Viki-14/Projekt_BMS/BMS_PCB - V2/Bauteile/AMC1350DWVR/3D/AMC1350DWVR.stp

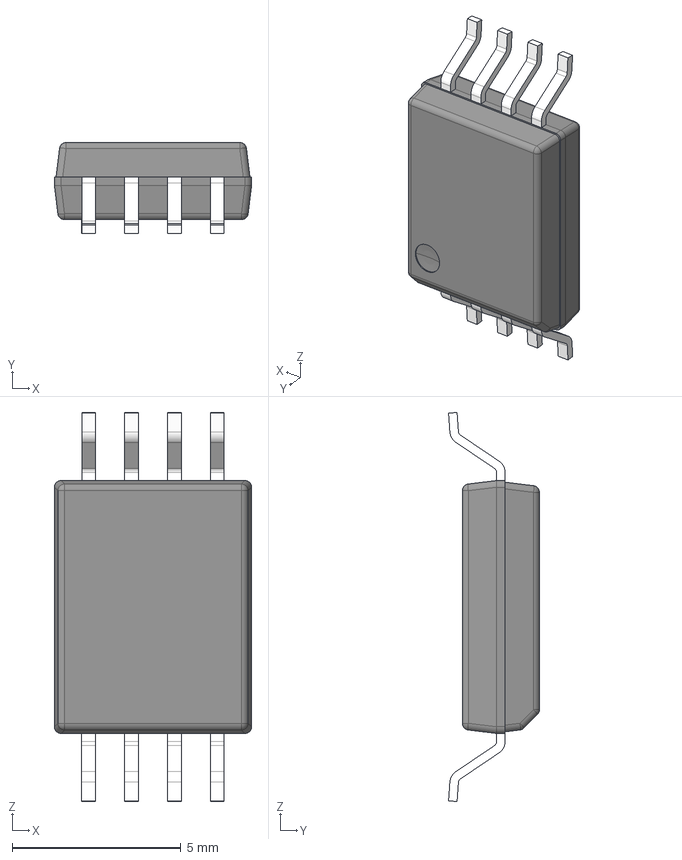
[picture p1: CAD file, 2025-04-29]
BMS_PCB - V2/Bauteile/AMC1350DWVR/3D/AMC1350DWVR.stp
5.85 x 2.70 x 11.5 mm
BODY-SOIC
LEAD-DWV0008A x 8
