Viki-14/Projekt_BMS/BMS_PCB - V2/Bauteile/LIB_REC15E-2412SZ/REC15E-2412SZ/3D/REC15E-2412SZ.stp

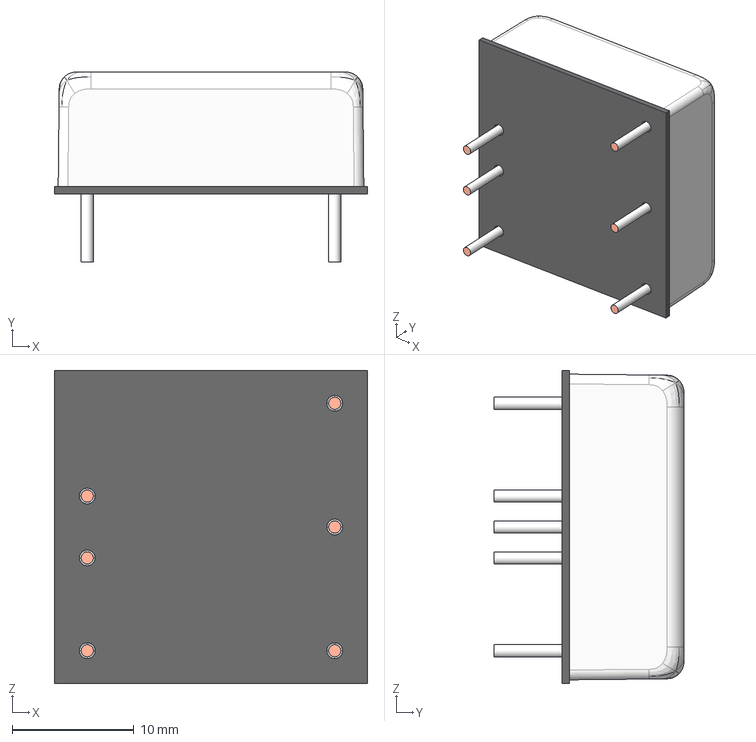
[picture p2: CAD file, 2025-04-29]
BMS_PCB - V2/Bauteile/LIB_REC15E-2412SZ/REC15E-2412SZ/3D/REC15E-2412SZ.stp
25.7 x 15.6 x 25.7 mm
