Viki-14/Projekt_BMS/BMS_PCB - V2/Bauteile/R1SE-0505-R/3D/R1SE-0505-R.stp

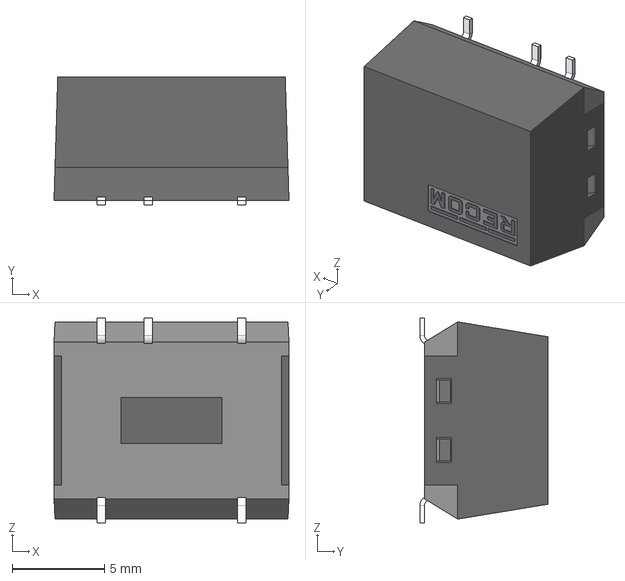
[picture p3: CAD file, 2025-04-29]
BMS_PCB - V2/Bauteile/R1SE-0505-R/3D/R1SE-0505-R.stp
12.8 x 6.95 x 11.1 mm
