Viki-14/Projekt_BMS/BMS_PCB - V2/Bauteile/TLV2401IDBVR/3D/TLV2401IDBVR.stp

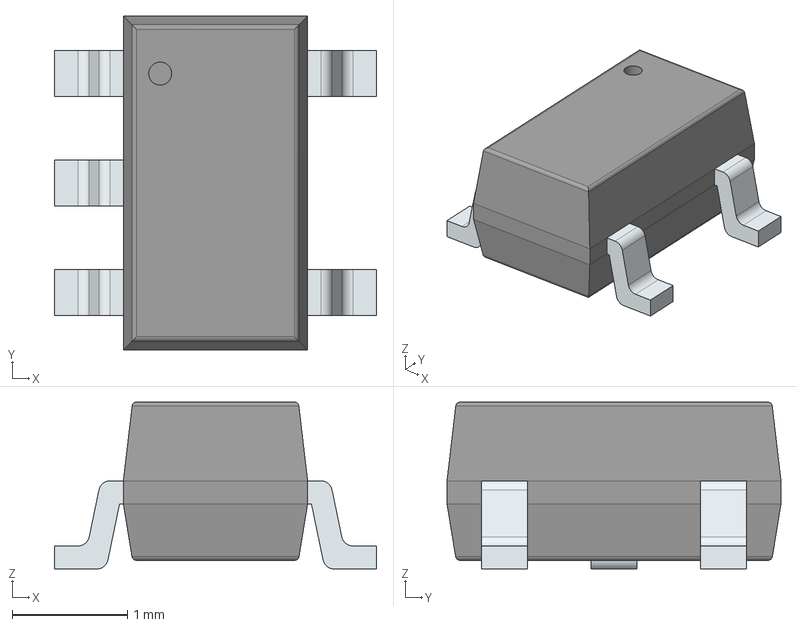
[picture p4: CAD file, 2025-04-29]
BMS_PCB - V2/Bauteile/TLV2401IDBVR/3D/TLV2401IDBVR.stp
2.80 x 2.90 x 1.45 mm
PinsArrayL
PinsArrayR
