Viki-14/Projekt_BMS/BMS_PCB - V2/Bauteile/TLV2402IDR/D0008A.stp

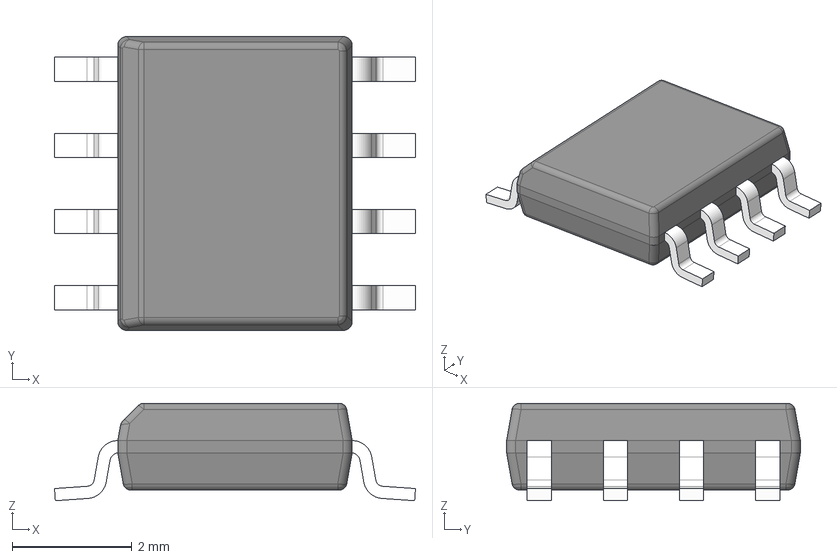
[picture p5: CAD file, 2025-04-29]
BMS_PCB - V2/Bauteile/TLV2402IDR/D0008A.stp
6.02 x 4.90 x 1.63 mm
BODY-SO
LEAD-D0008A x 8
