Viki-14/Projekt_BMS/BMS_PCB - V2/Bauteile/TLV2404IPW/PW0014A.stp

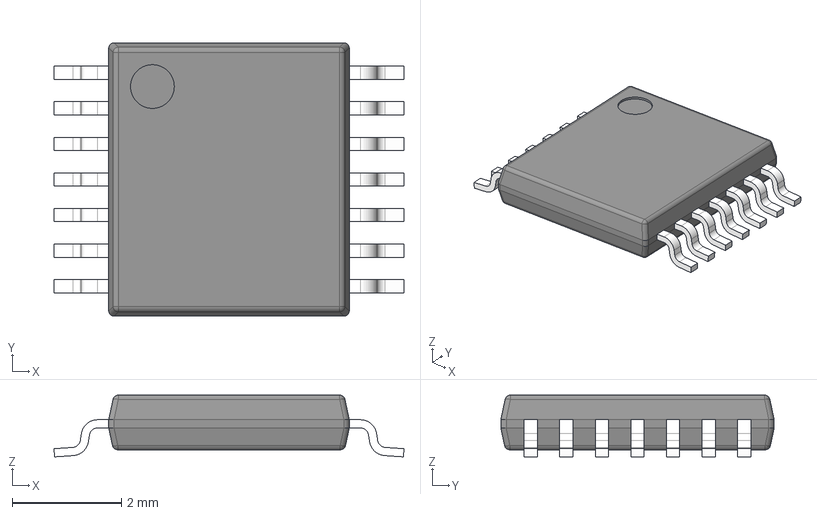
[picture p6: CAD file, 2025-04-29]
BMS_PCB - V2/Bauteile/TLV2404IPW/PW0014A.stp
6.40 x 5.00 x 1.13 mm
BODY-TSSOP
LEAD-TSSOP x 14
PIN1
