Viki-14/Projekt_BMS/BMS_PCB - V2/Bauteile/TPS70933DBVT/DBV0005A.stp

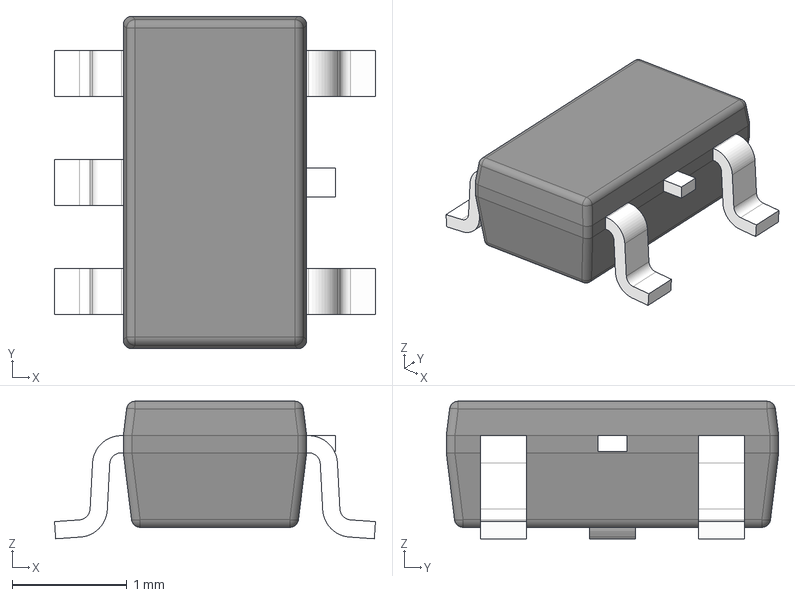
[picture p7: CAD file, 2025-04-29]
BMS_PCB - V2/Bauteile/TPS70933DBVT/DBV0005A.stp
2.80 x 2.90 x 1.20 mm
BODY-SOT
LEAD-SOT x 5
LEAD-DUMMY
