Viki-14/Projekt_BMS/BMS_PCB - V2/BMS_PCB.step

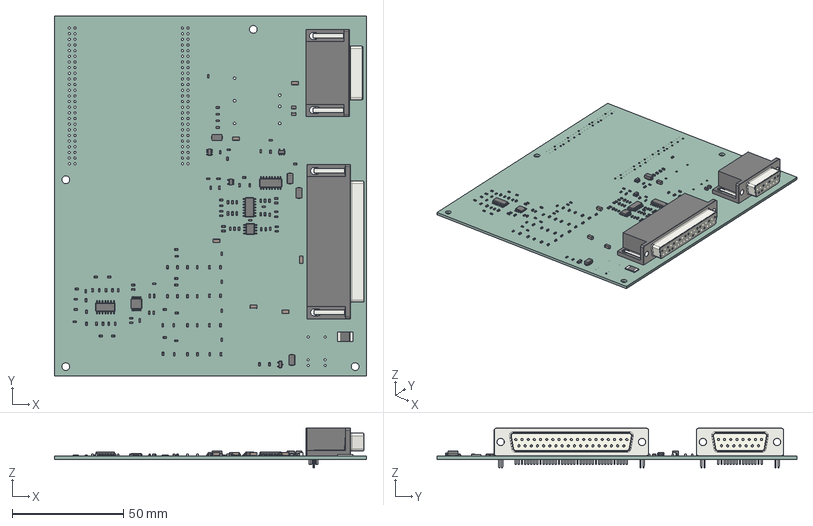
[picture p8: CAD file, 2025-05-05]
BMS_PCB - V2/BMS_PCB.step
140.2 x 161.7 x 17.9 mm
R_0603_1608Metric x 65
C_1206_3216Metric x 6
C_0603_1608Metric x 55
SOT-23-5 x 2
SOT-23-6
C_0805_2012Metric x 2
DSUB-37_Socket_Horizontal_P2.77x2.84mm_EdgePinOffset14.56mm_Housed_ MountingHolesOffset15.98mm
SOIC-16_3.9x9.9mm_P1.27mm
D_SMA x 4
DSUB-15_Socket_Horizontal_P2.77x2.84mm_EdgePinOffset14.56mm_Housed_ MountingHolesOffset15.98mm
SOIC-14_3.9x8.7mm_P1.27mm x 2
SOIC-8_3.9x4.9mm_P1.27mm
SOT-23-3
TSSOP-14_4.4x5mm_P0.65mm
R_2816_7142Metric
BMS_PCB_PCB
