Viki-14/Projekt_BMS/BMS_PCB - V2/Bauteile/TPS560430XFDBVT/3D/TPS560430XFDBVT.stp

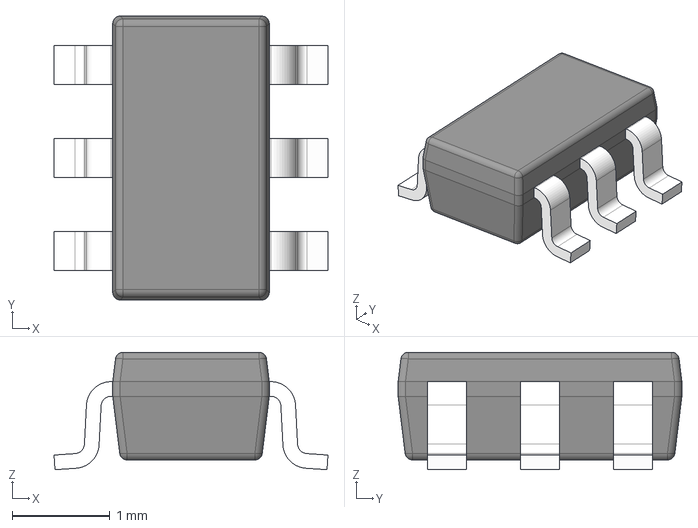
[picture p9: CAD file, 2025-04-29]
BMS_PCB - V2/Bauteile/TPS560430XFDBVT/3D/TPS560430XFDBVT.stp
2.80 x 2.90 x 1.20 mm
BODY-SOT
LEAD-SOT x 6
