Viki-14/Projekt_BMS/(list of files, cad)

Other CAD files:
BMS_PCB - V2/Bauteile/AMC1350DWVR/Allegro/soic127p1150x280-8n.psm
BMS_PCB - V2/Bauteile/AMC1350DWVR/DEHDL/amc1350dwvr/chips/chips.prt
BMS_PCB - V2/Bauteile/LIB_REC15E-2412SZ/REC15E-2412SZ/Allegro/rec15e2412sz.psm
BMS_PCB - V2/Bauteile/LIB_REC15E-2412SZ/REC15E-2412SZ/DEHDL/rec15e_2412sz/chips/chips.prt
BMS_PCB - V2/Bauteile/R1SE-0505-R/Allegro/r1se0505.psm
BMS_PCB - V2/Bauteile/R1SE-0505-R/DEHDL/r1se_0505_r/chips/chips.prt
BMS_PCB - V2/Bauteile/TLV2401IDBVR/Allegro/sot95p280x145-5n.psm
BMS_PCB - V2/Bauteile/TLV2401IDBVR/DEHDL/tlv2401idbvr/chips/chips.prt
BMS_PCB - V2/Bauteile/TPS560430XFDBVT/Allegro/sot95p280x145-6n.psm
BMS_PCB - V2/Bauteile/TPS560430XFDBVT/DEHDL/tps560430xfdbvt/chips/chips.prt
