Viki-14/Projekt_BMS/BMS_PCB - V2/BMS_PCB_schematic_v3.pdf

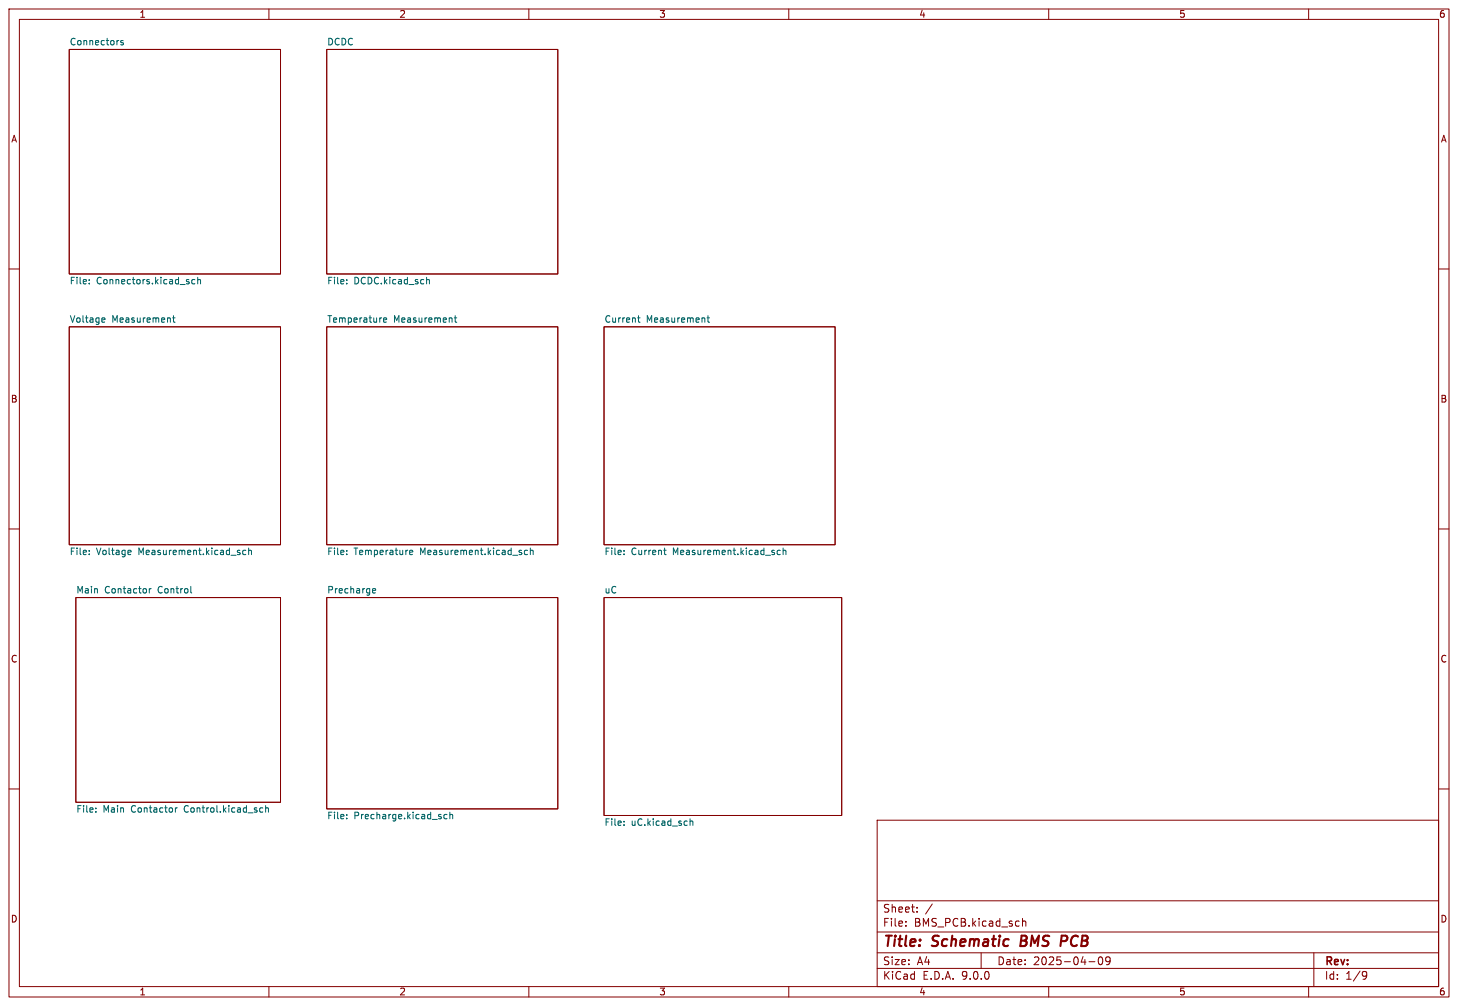
[picture p10: page 1]

Current Measurement File: Current Measurement.kicad_sch

File: uC.kicad_sch Precharge File: Precharge.kicad_sch

File: BMS_PCB.kicad_sch Sheet: /
Id: 1/9 Title: Schematic BMS PCB

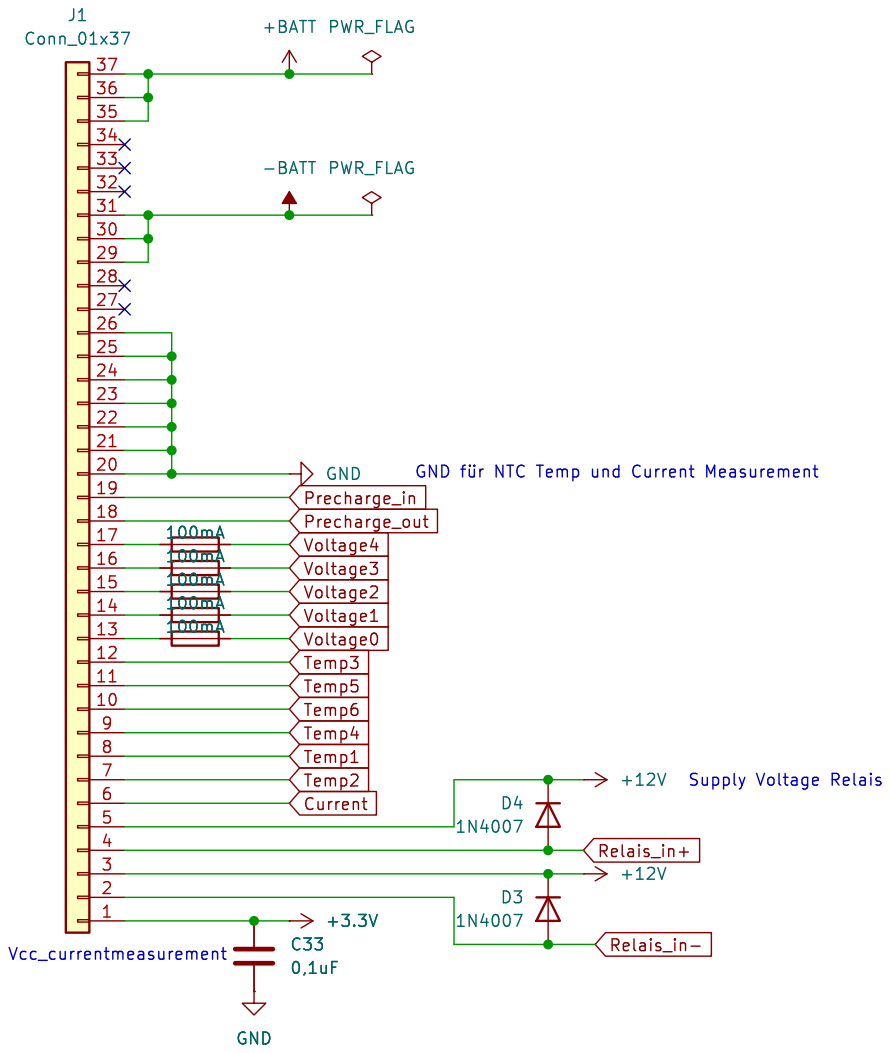
[picture p11: page 2]

Id: 2/9 Title: File: Connectors.kicad_sch Sheet: /Connectors/ D3

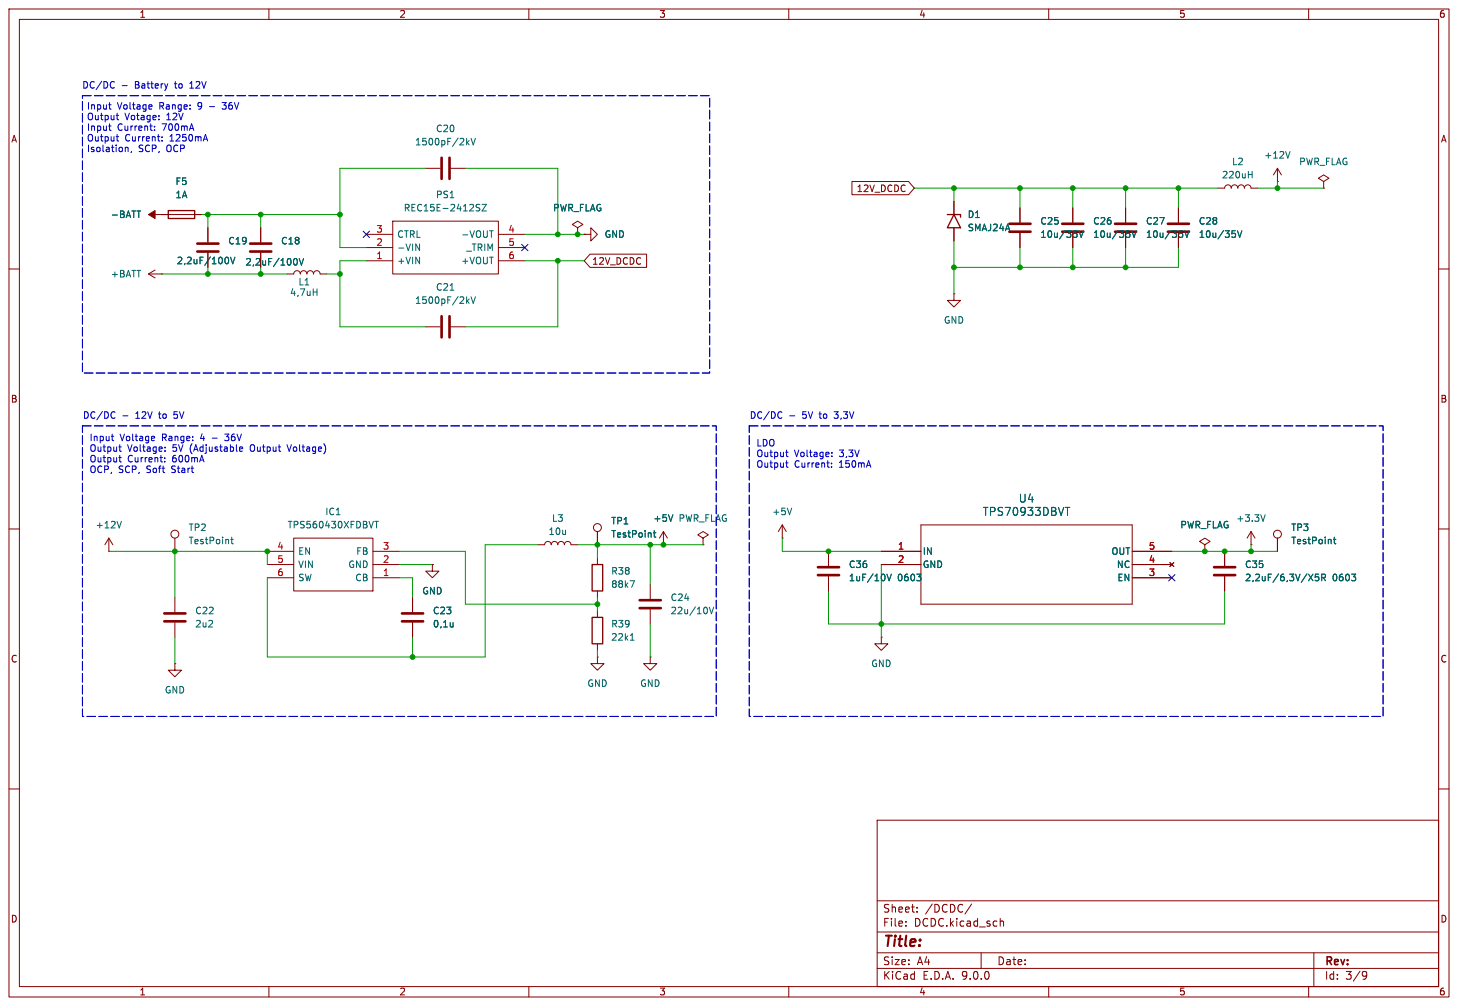
[picture p12: page 3]

Input Voltage Range: 9 - 36V Output Votage: 12V

Input Current: 700mA Output Current: 1250mA

LDO
Output Voltage: 3,3V Output Current: 150mA

Id: 3/9 Title: File: DCDC.kicad_sch Sheet: /DCDC/ C22

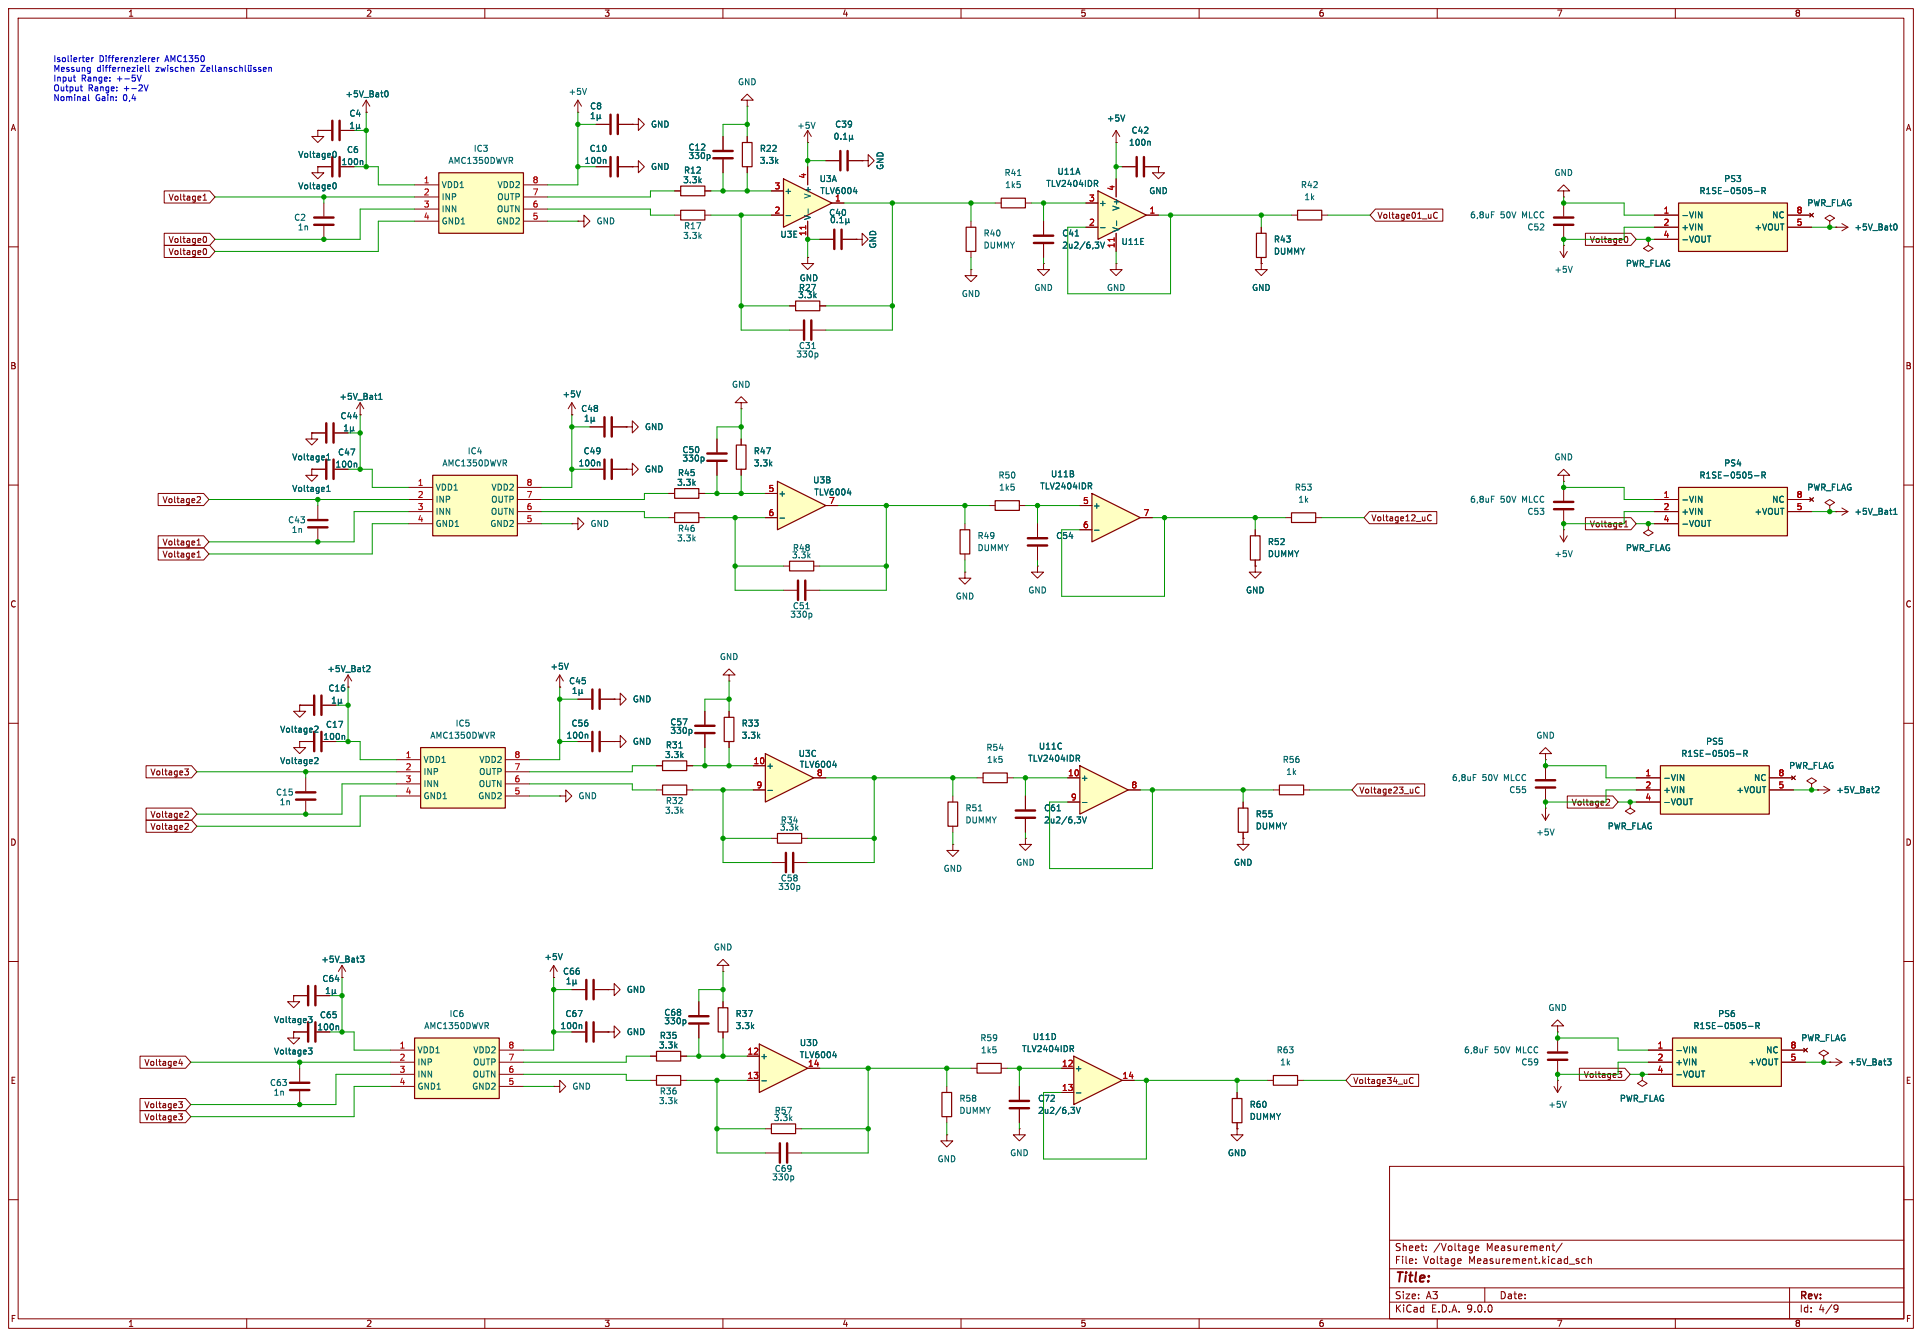
[picture p13: page 4]

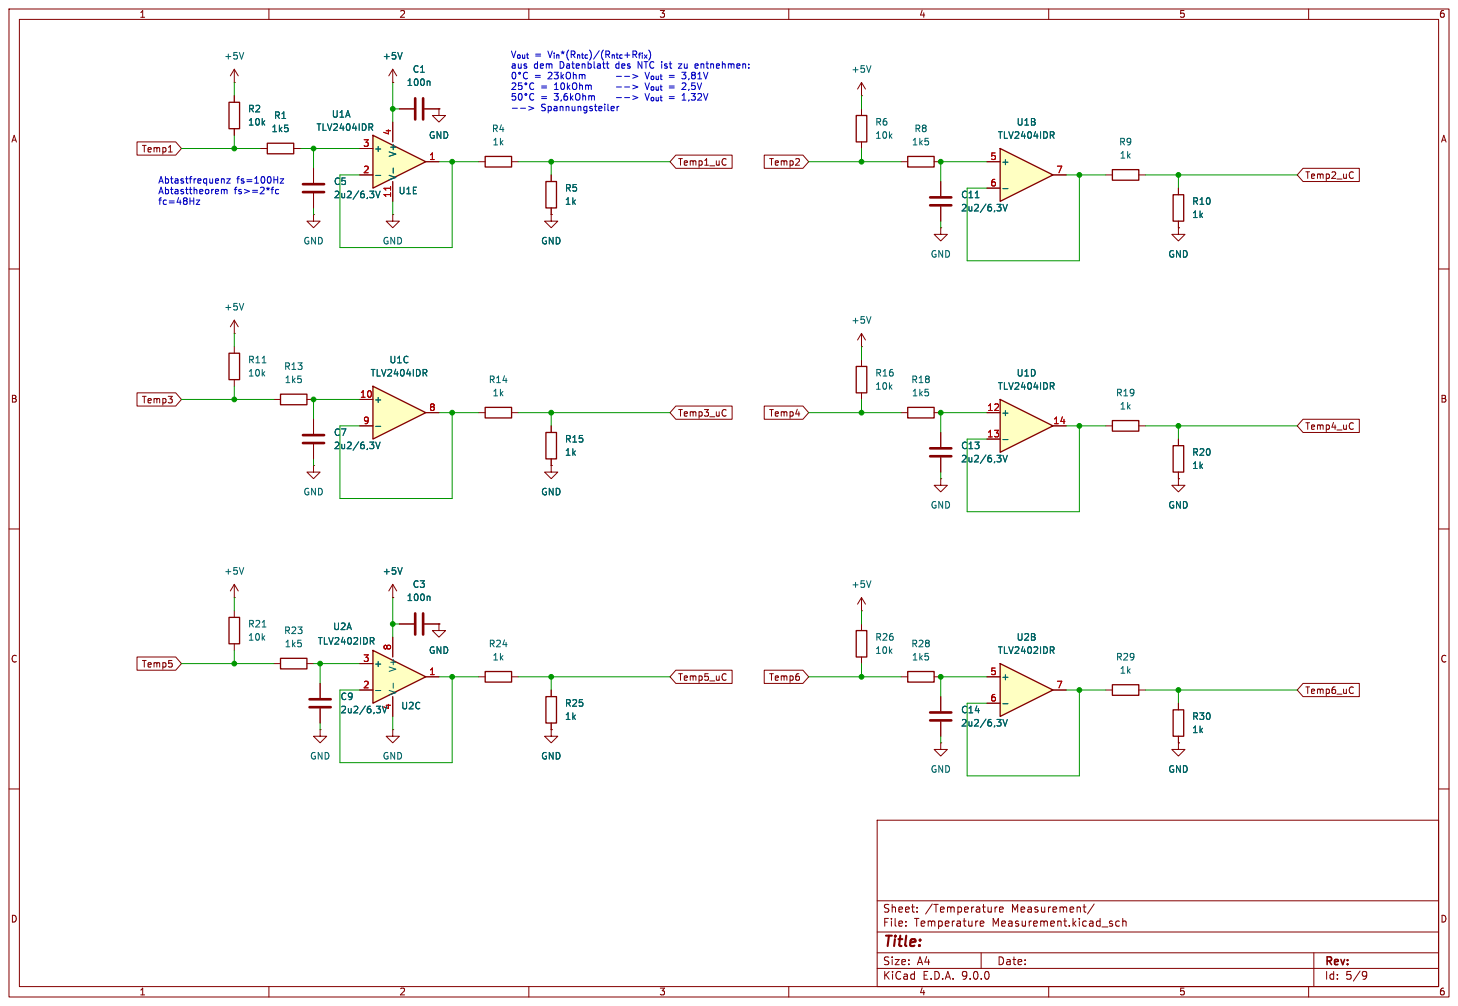
[picture p14: page 5]

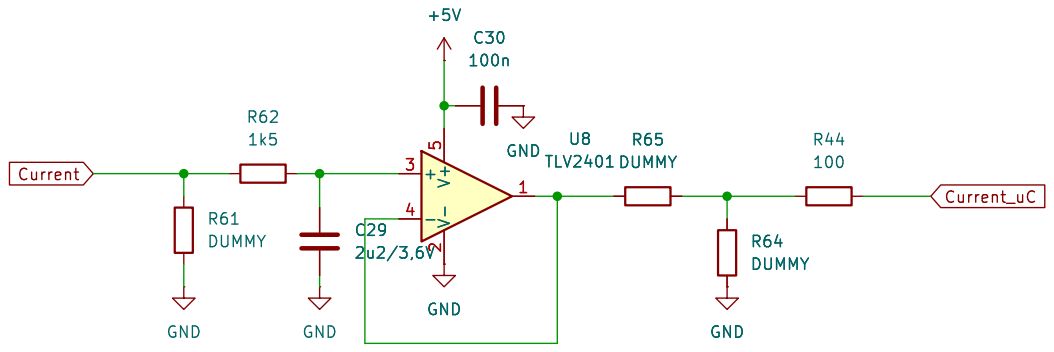
[picture p15: page 6]

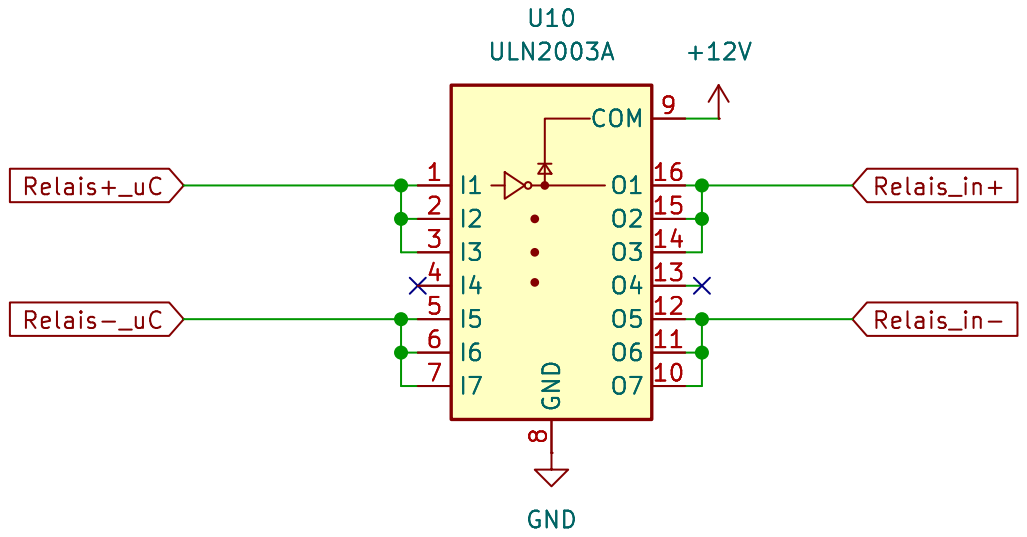
[picture p16: page 7]

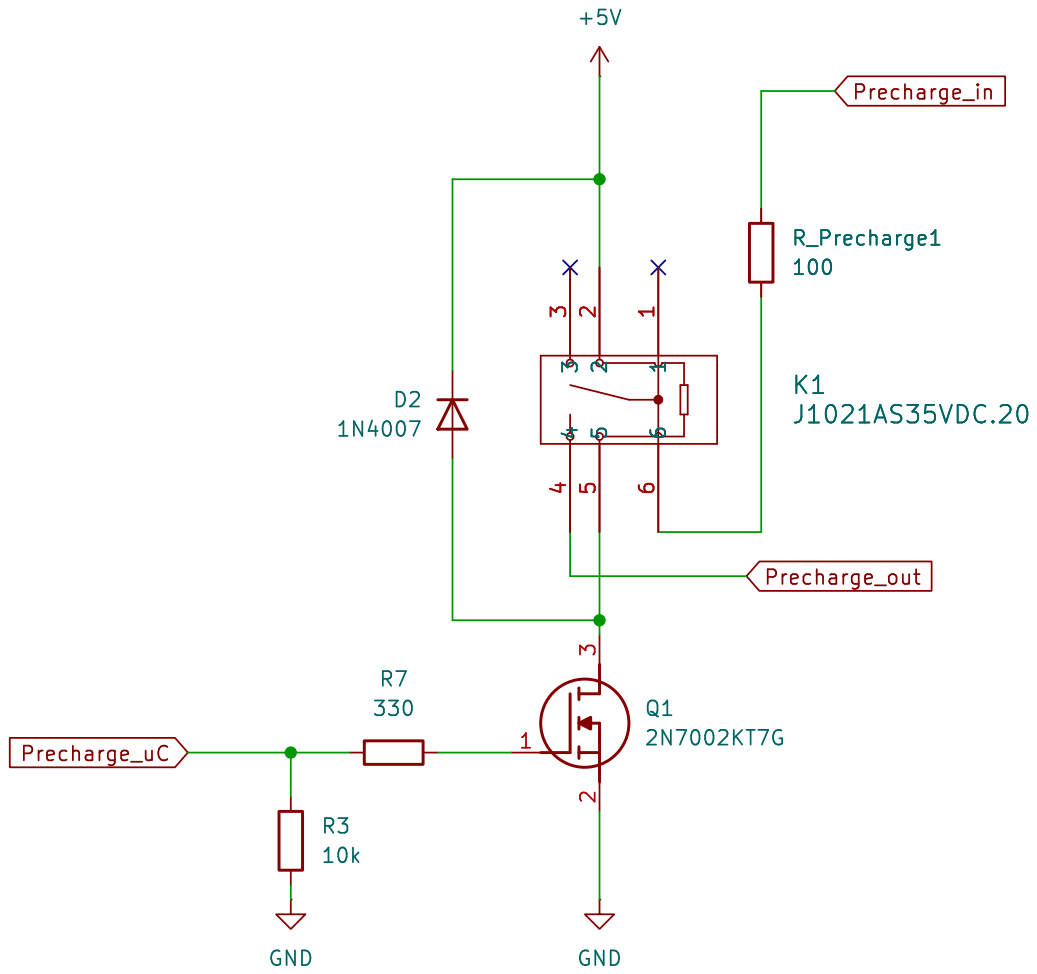
[picture p17: page 8]

Id: 8/9 Title: File: Precharge.kicad_sch Sheet: /Precharge/

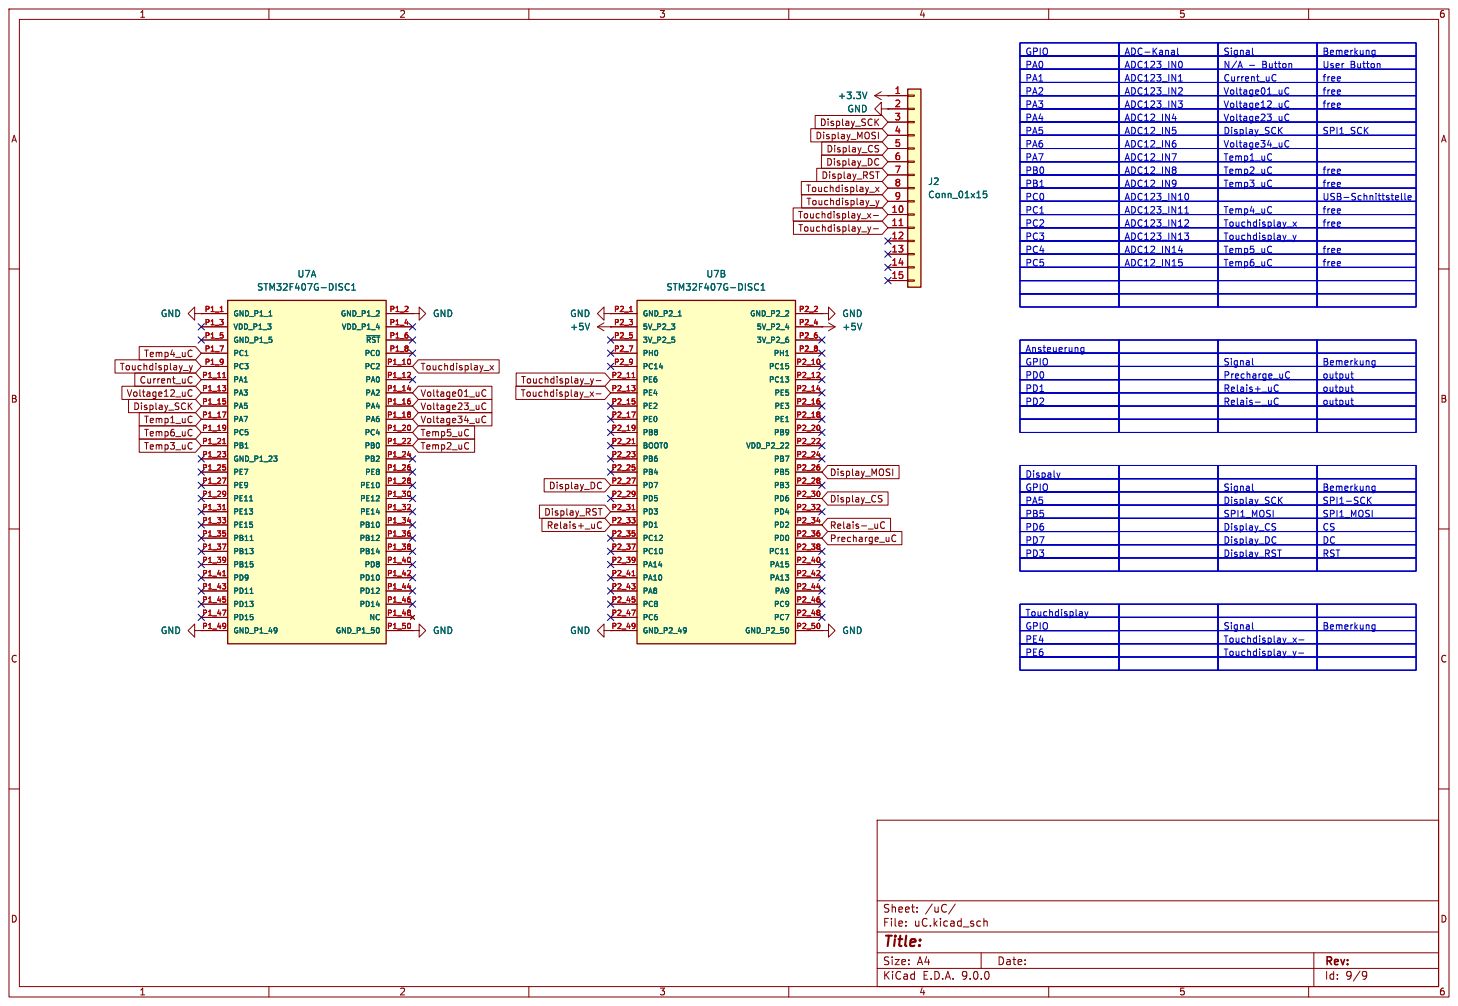
[picture p18: page 9]
