Viki-14/Projekt_BMS/BMS_PCB - V2/BMS_PCB.pdf

Current Measurement File: Current Measurement.kicad_sch

File: uC.kicad_sch Precharge File: Precharge.kicad_sch

File: BMS_PCB.kicad_sch Sheet: /
Id: 1/9 Title: Schematic BMS PCB

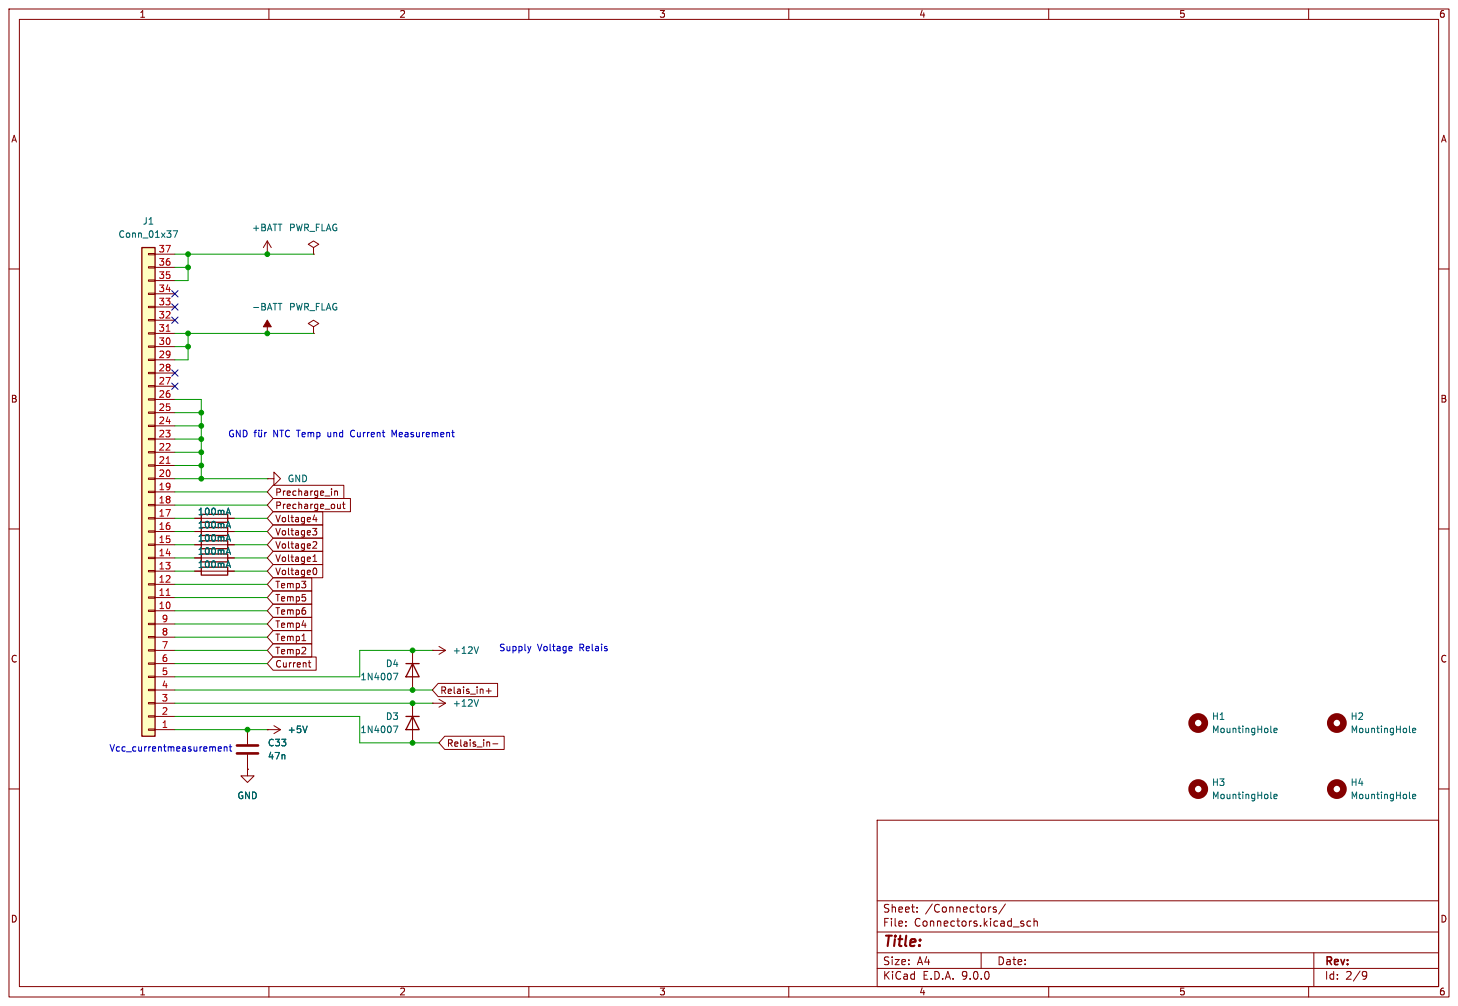
[picture p19: page 2]

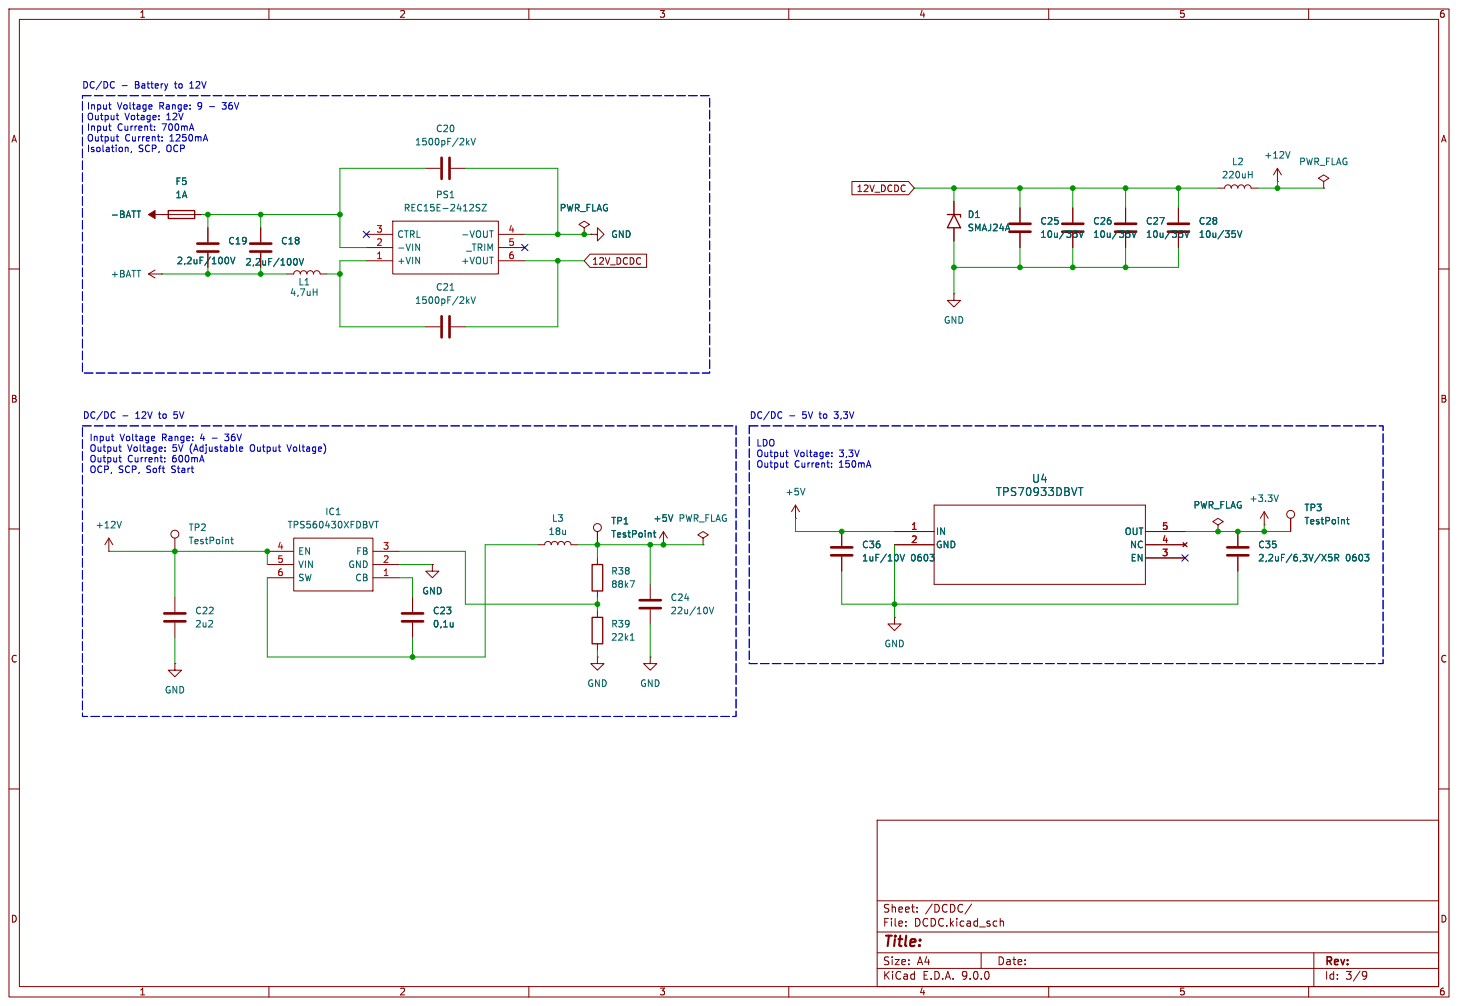
[picture p20: page 3]

Output Voltage: 3,3V Output Current: 150mA DC/DC - Battery to 12V DC/DC - 12V to 5V

Input Voltage Range: 9 - 36V Output Votage: 12V

Input Current: 700mA Output Current: 1250mA

Output Current: 600mA OCP, SCP, Soft Start
TP2 TestPoint C22

Id: 3/9 Title: File: DCDC.kicad_sch Sheet: /DCDC/


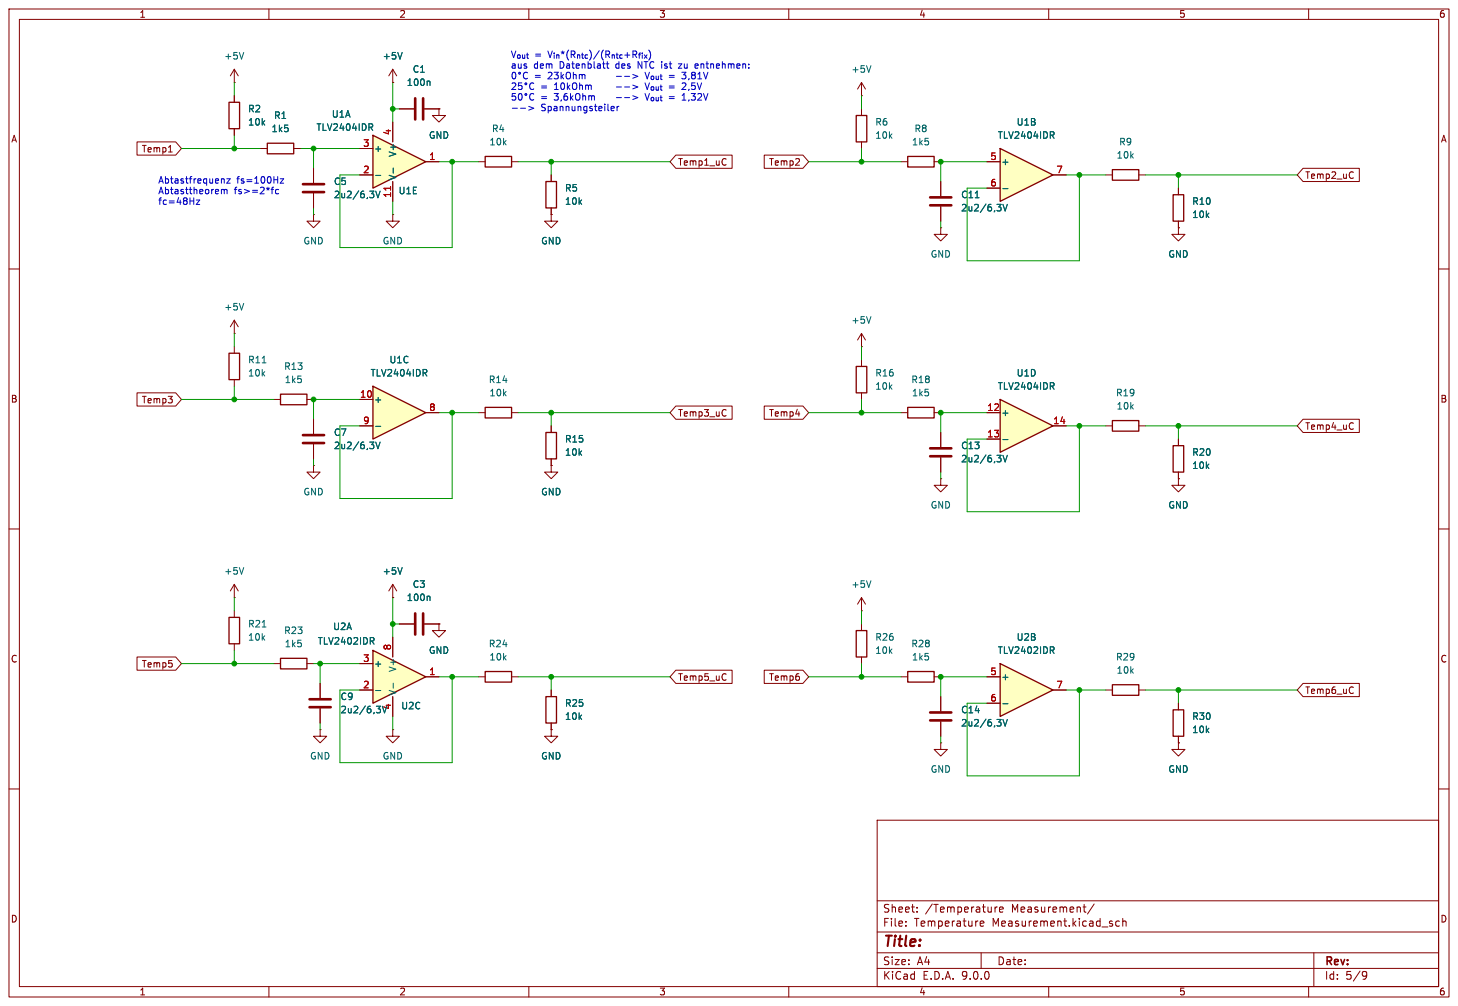
[picture p21: page 5]

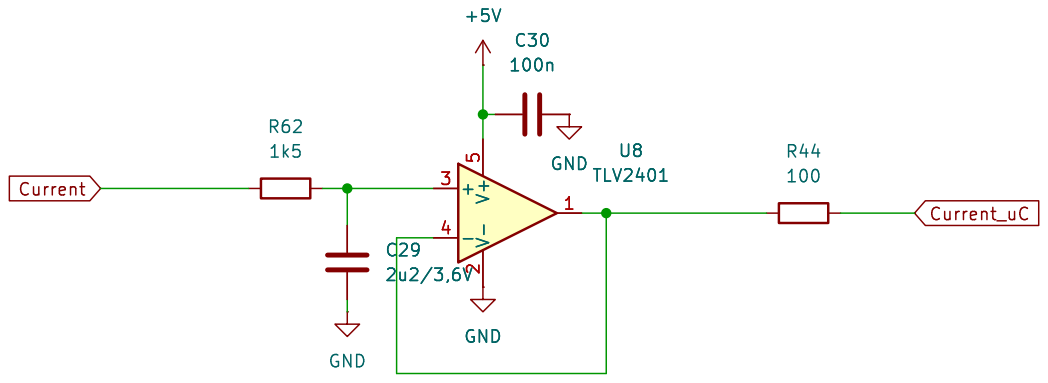
[picture p22: page 6]


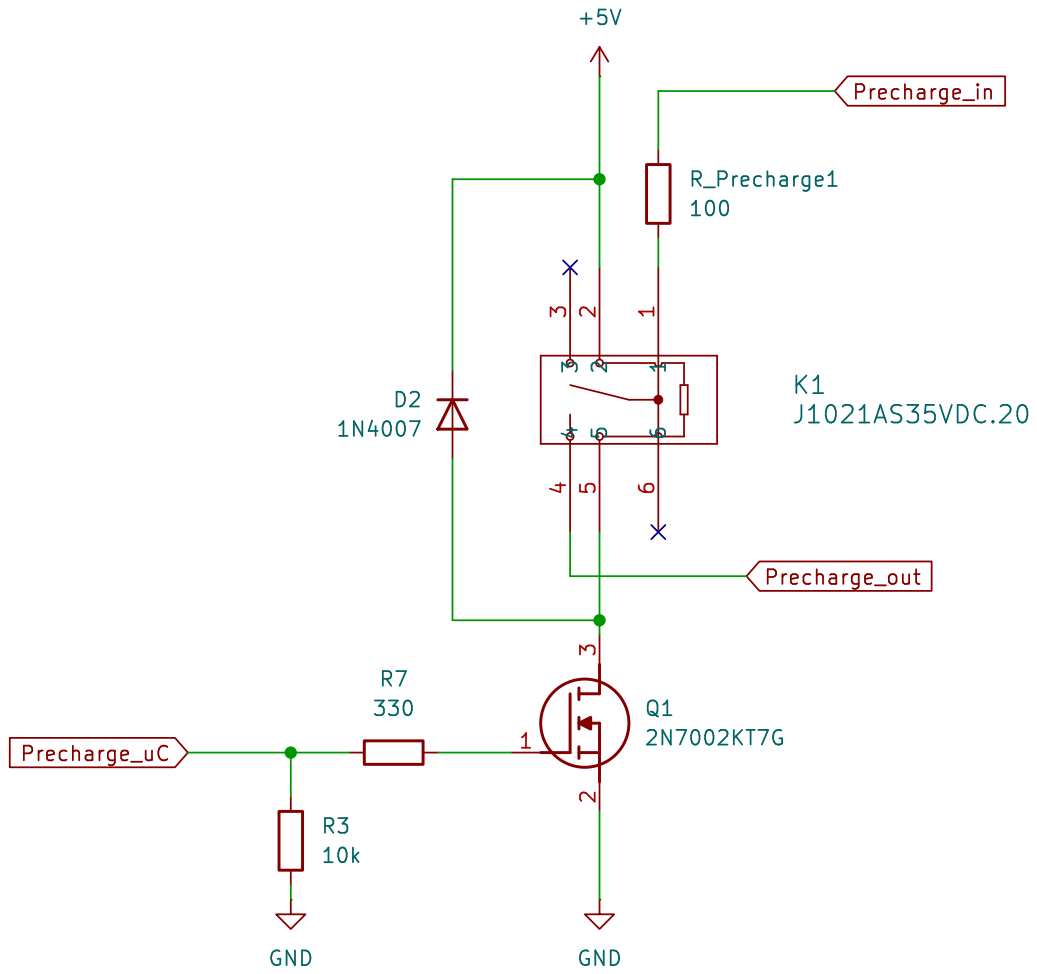
[picture p23: page 8]

Id: 8/9 Title: File: Precharge.kicad_sch Sheet: /Precharge/ R3

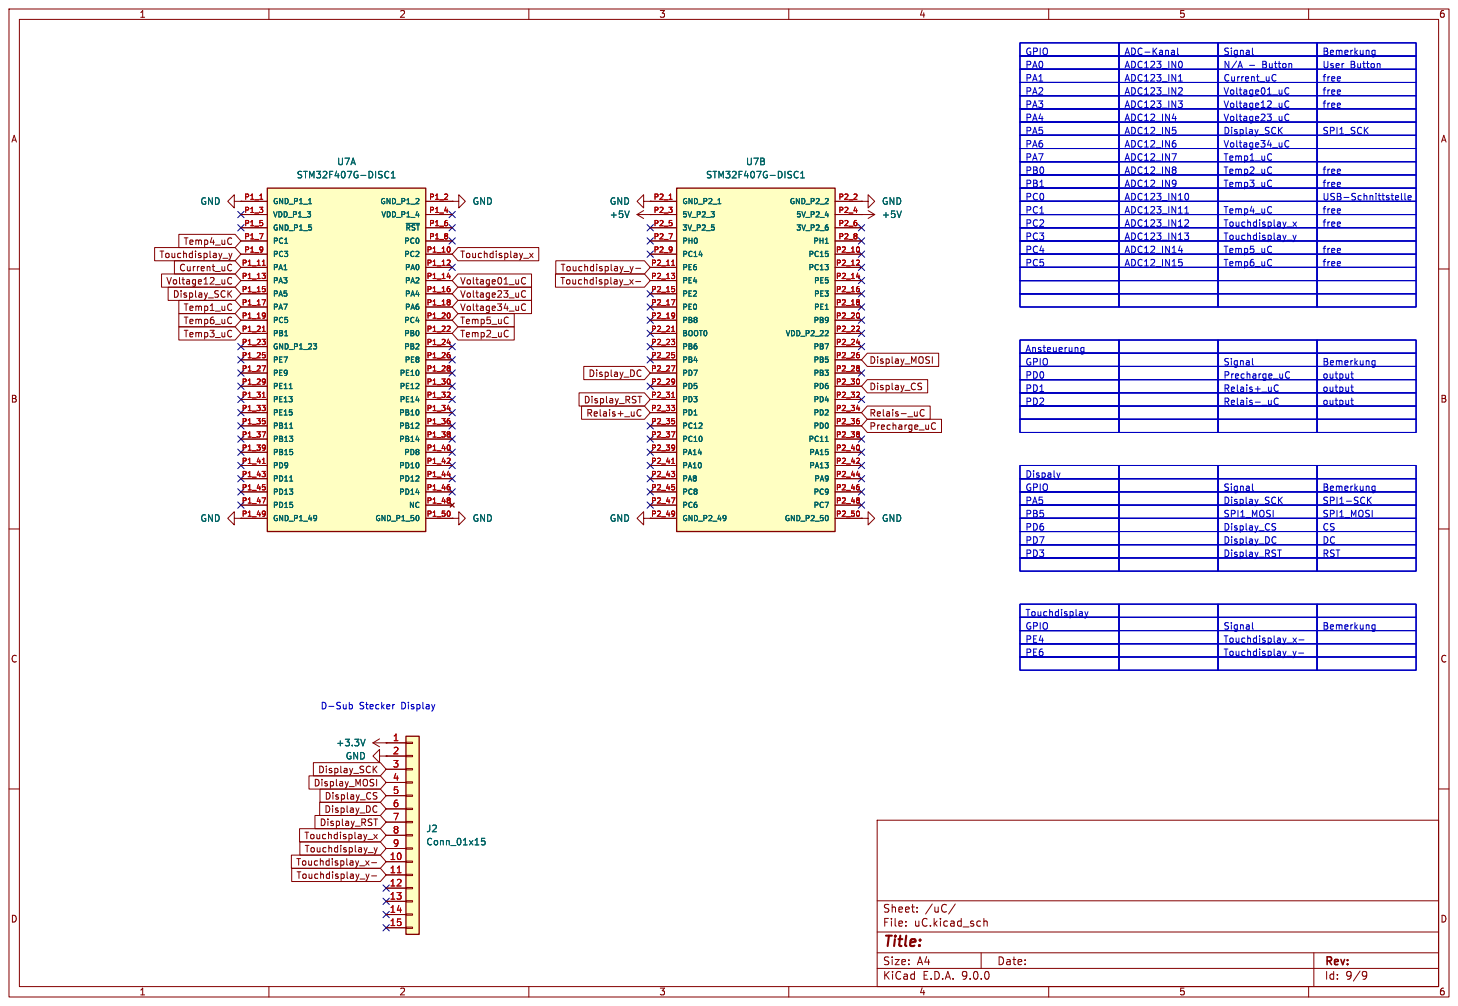
[picture p24: page 9]

Id: 9/9 Title: File: uC.kicad_sch Sheet: /uC/
