Viki-14/Projekt_BMS/BMS_PCB - V2/BMS_PCB_schematic_v1.pdf

Current Measurement File: Current Measurement.kicad_sch

File: uC.kicad_sch Precharge File: Precharge.kicad_sch

File: BMS_PCB.kicad_sch Sheet: /
Id: 1/9 Title: Schematic BMS PCB

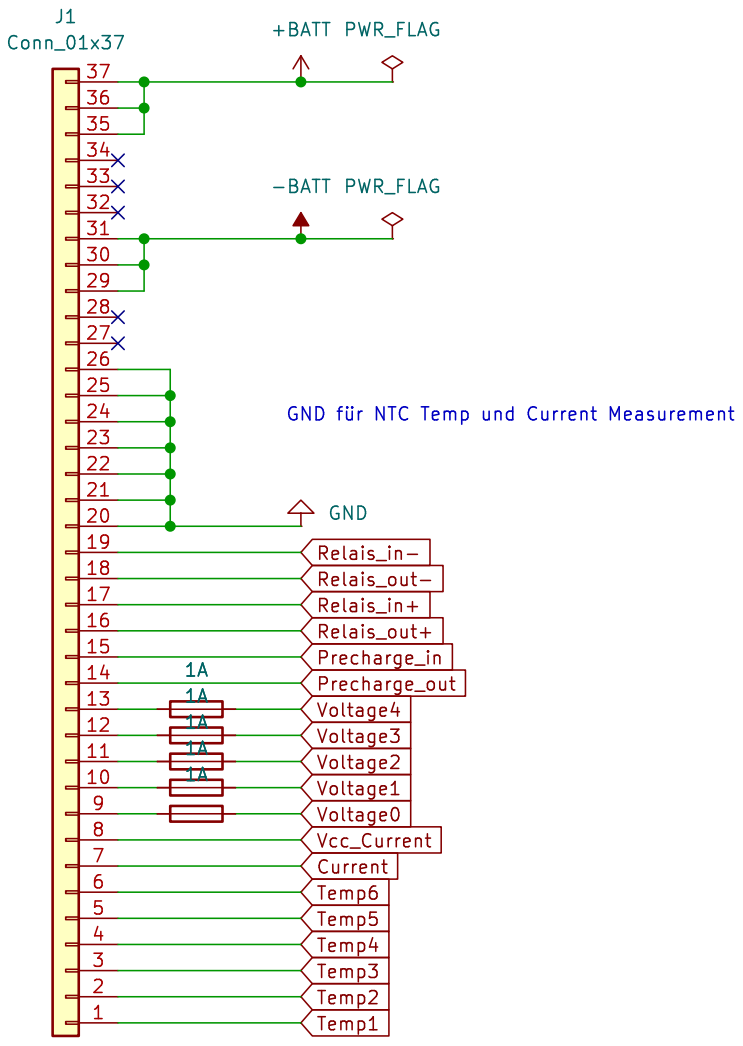
[picture p25: page 2]

Voltage2 Relais_out- Relais_in- Relais_in+ Relais_out+ GND þÿfür NTC Temp und Current Measurement 1A

Id: 2/9 Title: File: Connectors.kicad_sch Sheet: /Connectors/

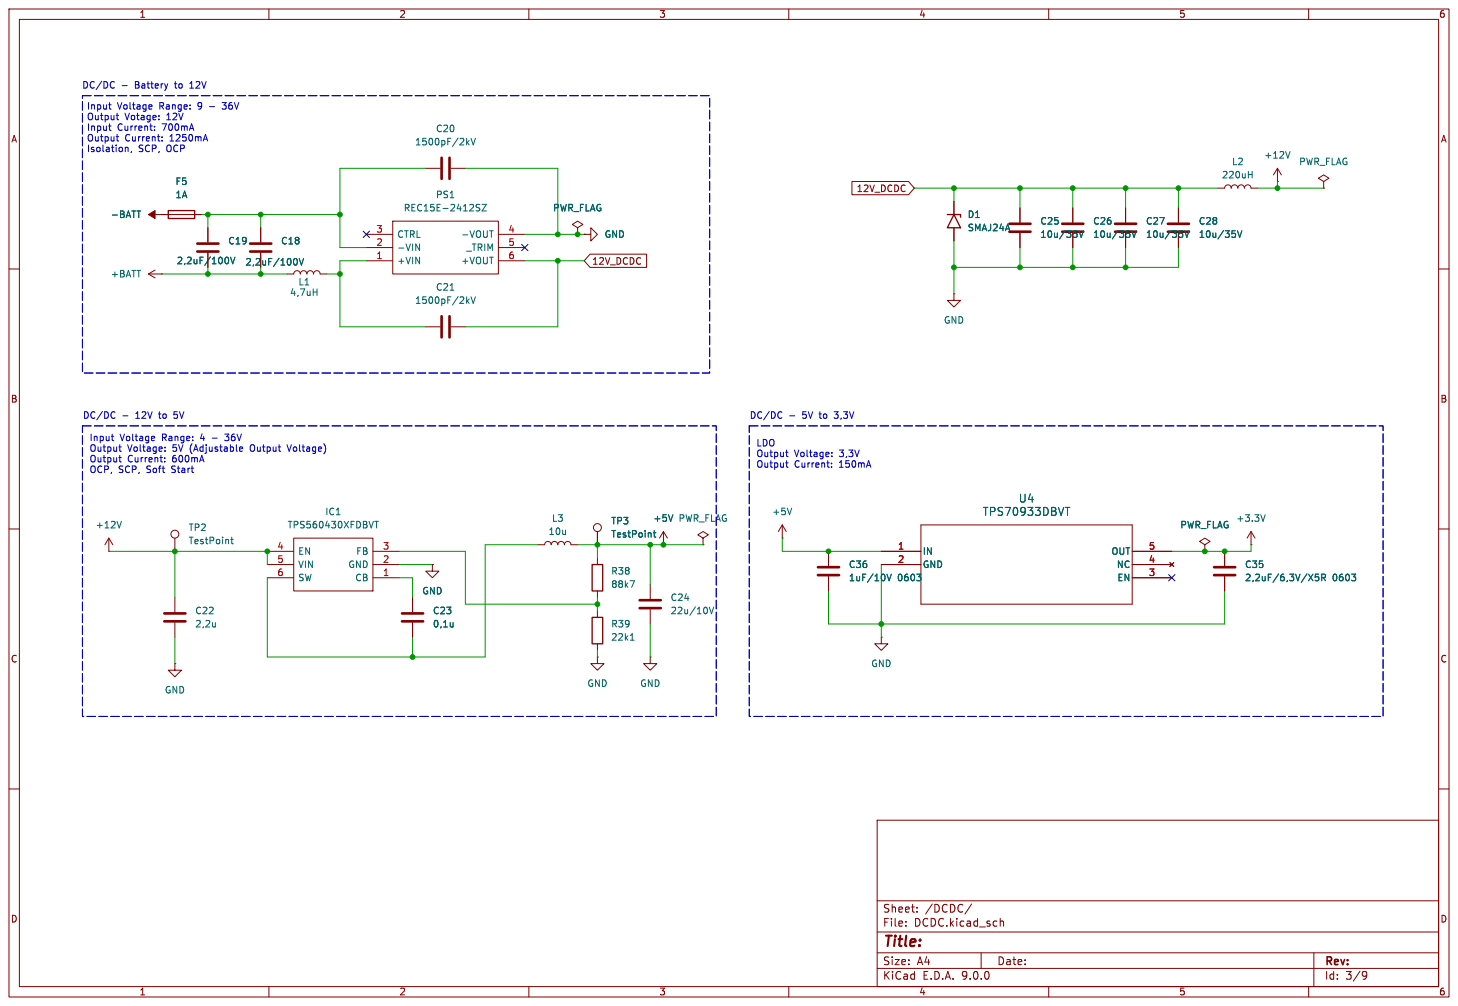
[picture p26: page 3]

Output Current: 600mA OCP, SCP, Soft Start DC/DC - 12V to 5V DC/DC - Battery to 12V

Input Voltage Range: 9 - 36V Output Votage: 12V

Input Current: 700mA Output Current: 1250mA

LDO
Output Voltage: 3,3V Output Current: 150mA

Id: 3/9 Title: File: DCDC.kicad_sch Sheet: /DCDC/

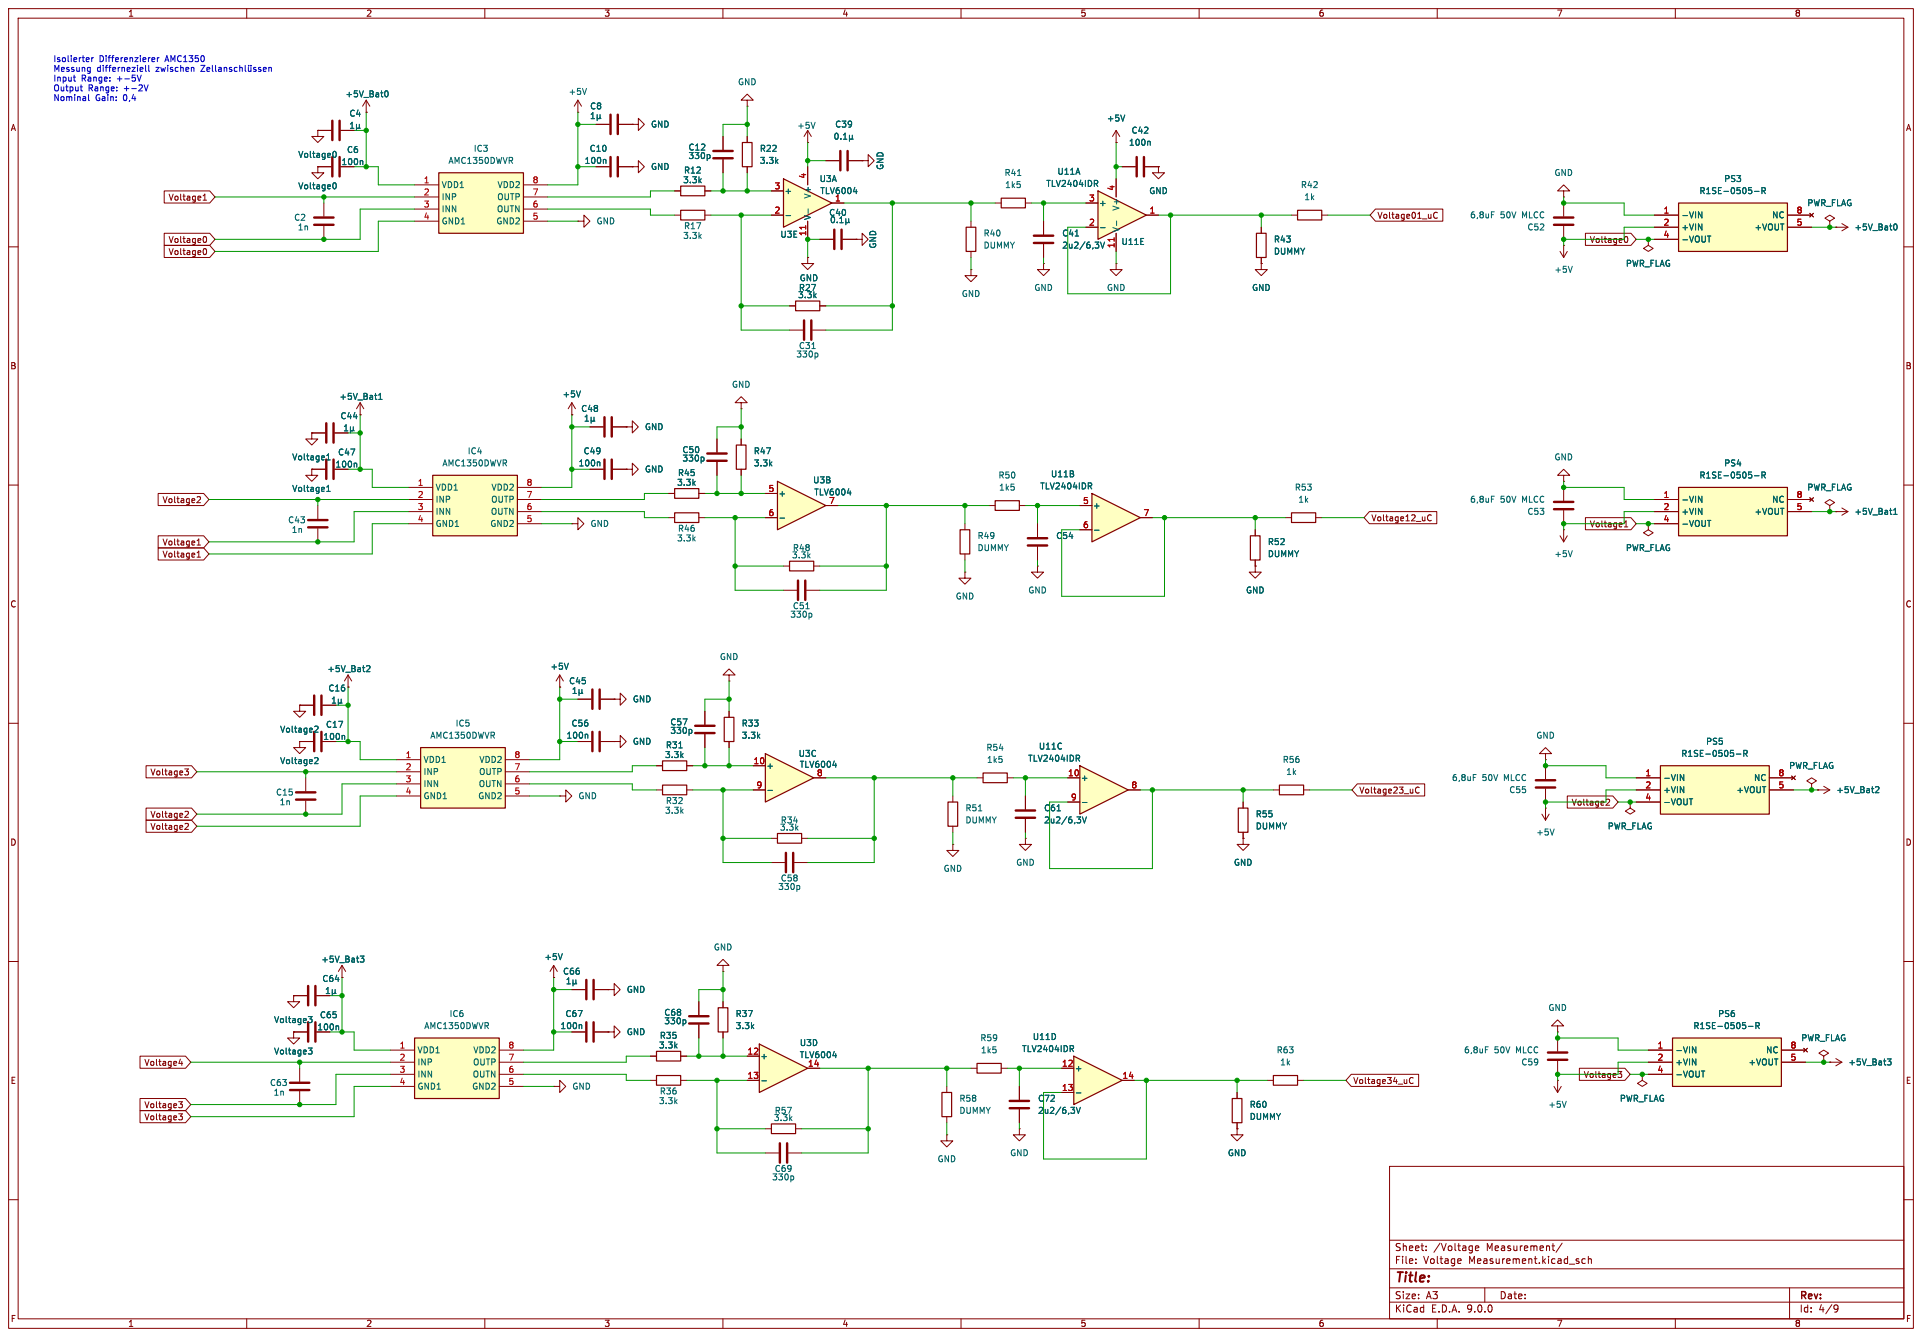
[picture p27: page 4]

4 V- 11U11E GND
R60 DUMMY R55 DUMMY R52 DUMMY R43 DUMMY

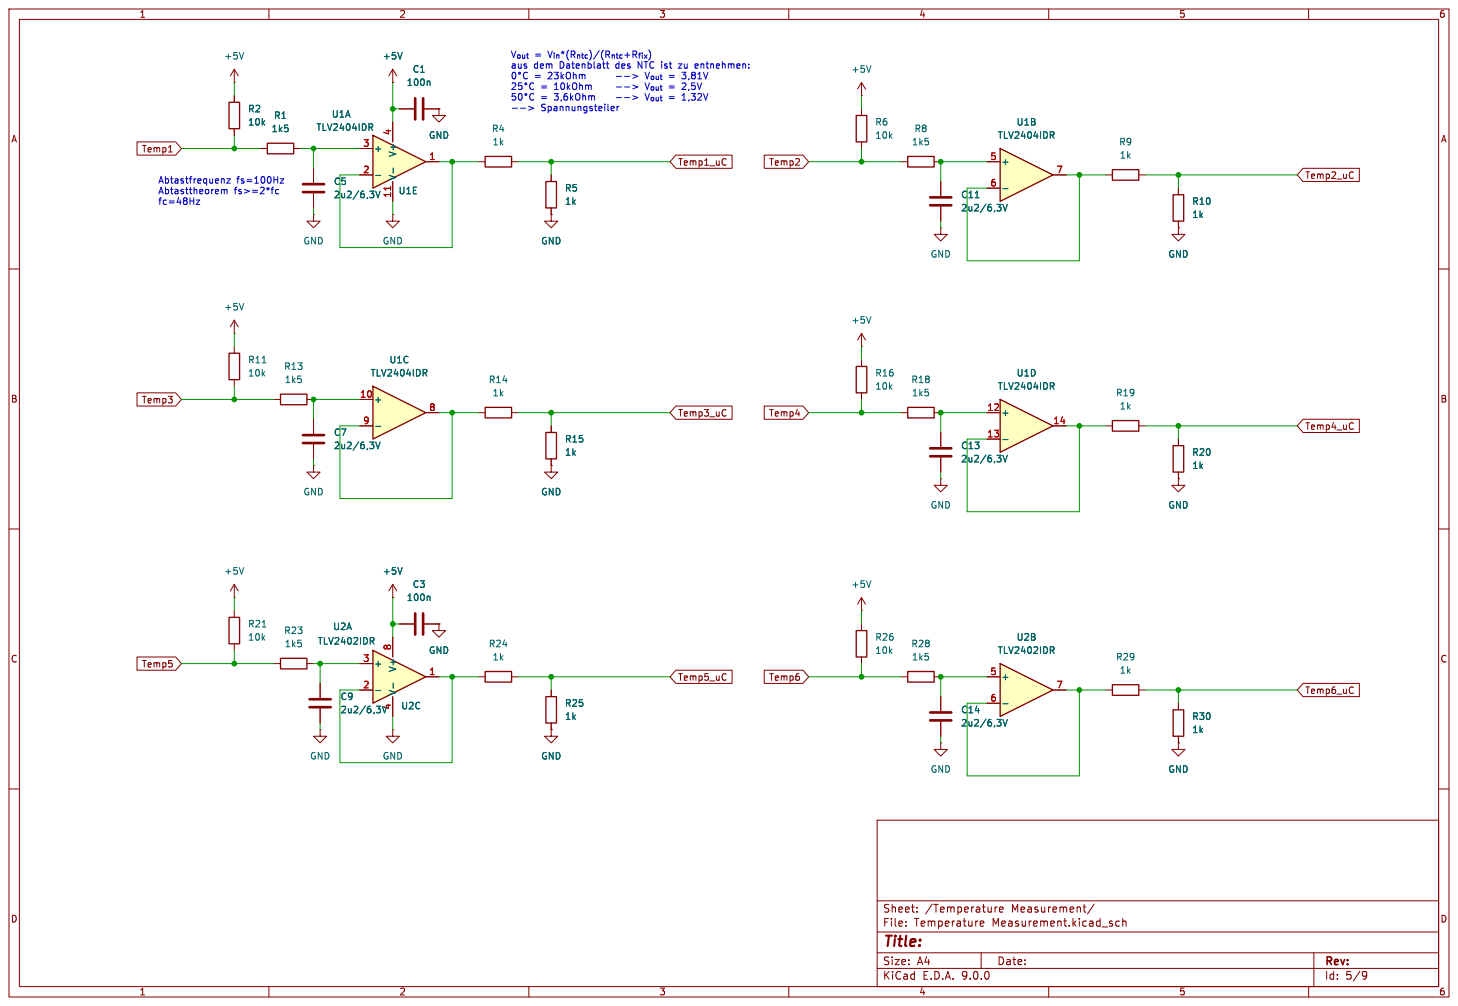
[picture p28: page 5]

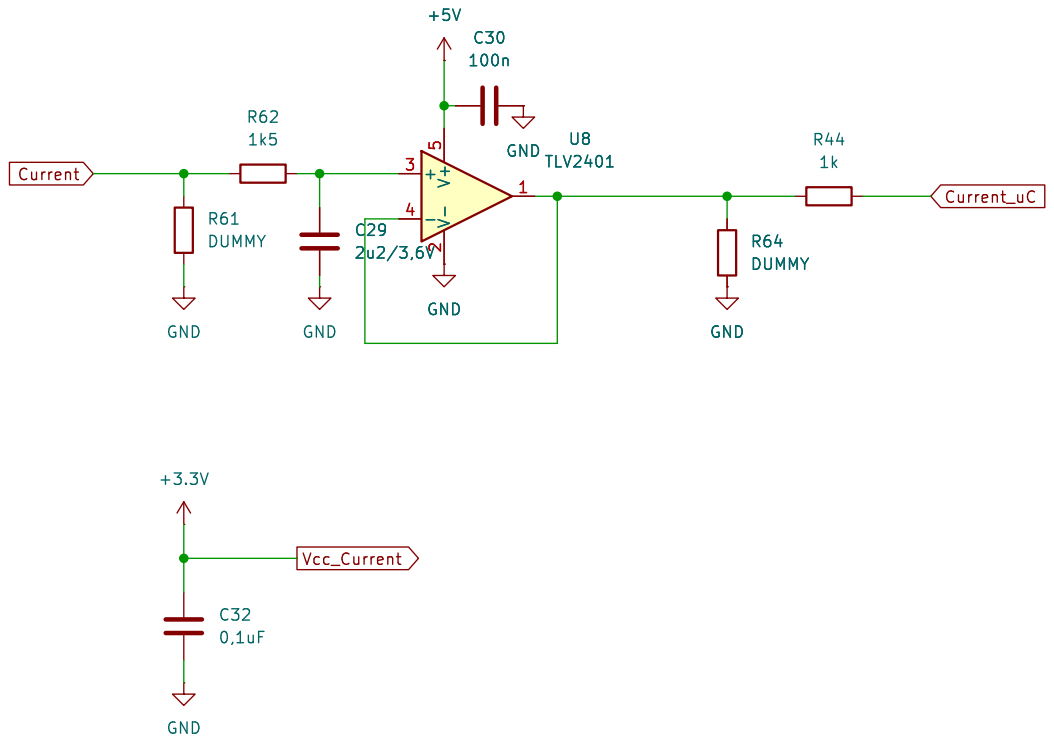
[picture p29: page 6]

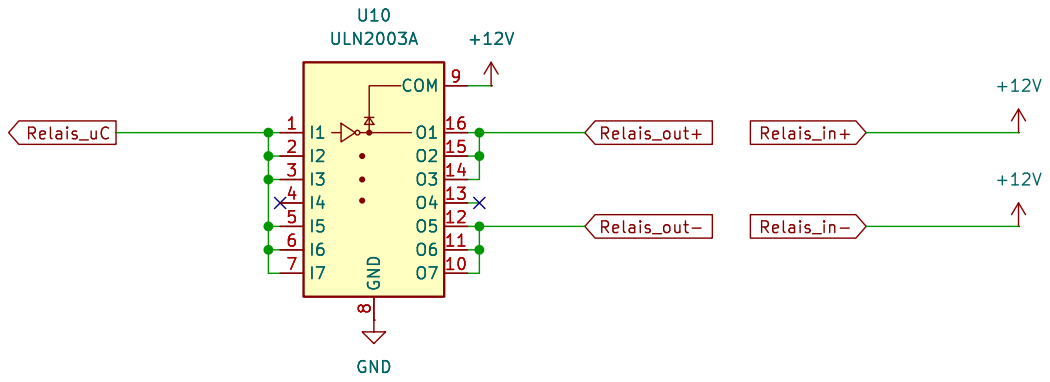
[picture p30: page 7]

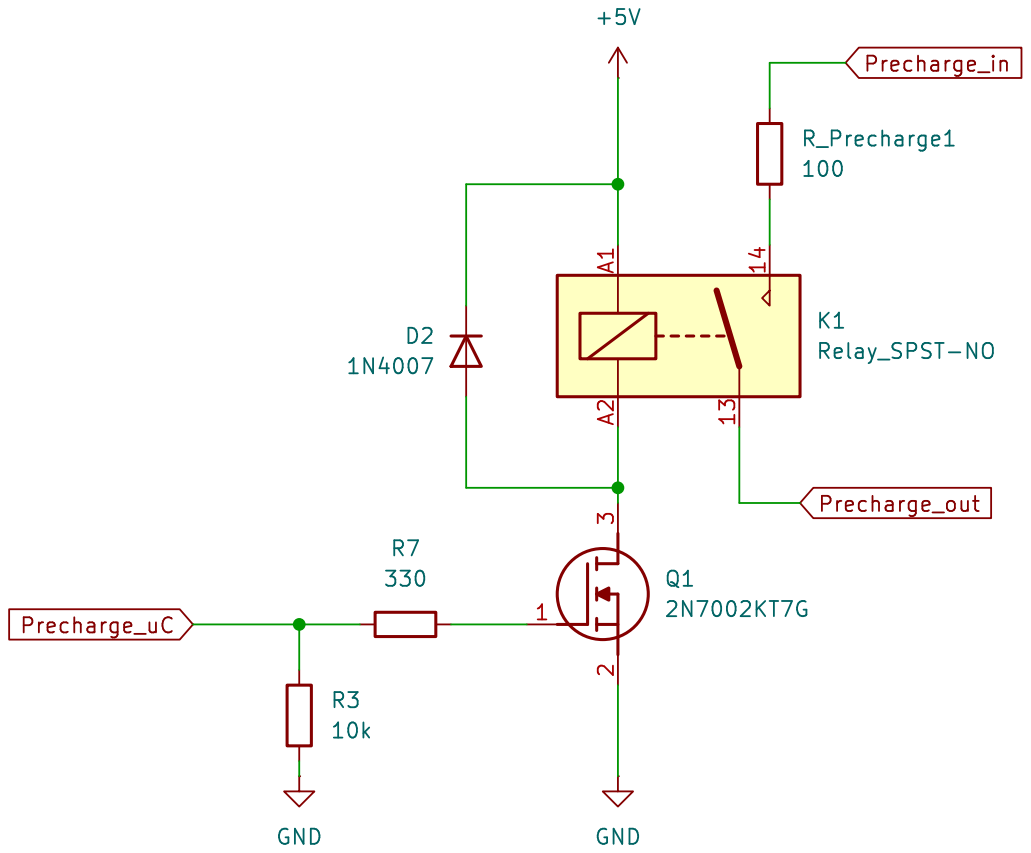
[picture p31: page 8]

Id: 8/9 Title: File: Precharge.kicad_sch Sheet: /Precharge/

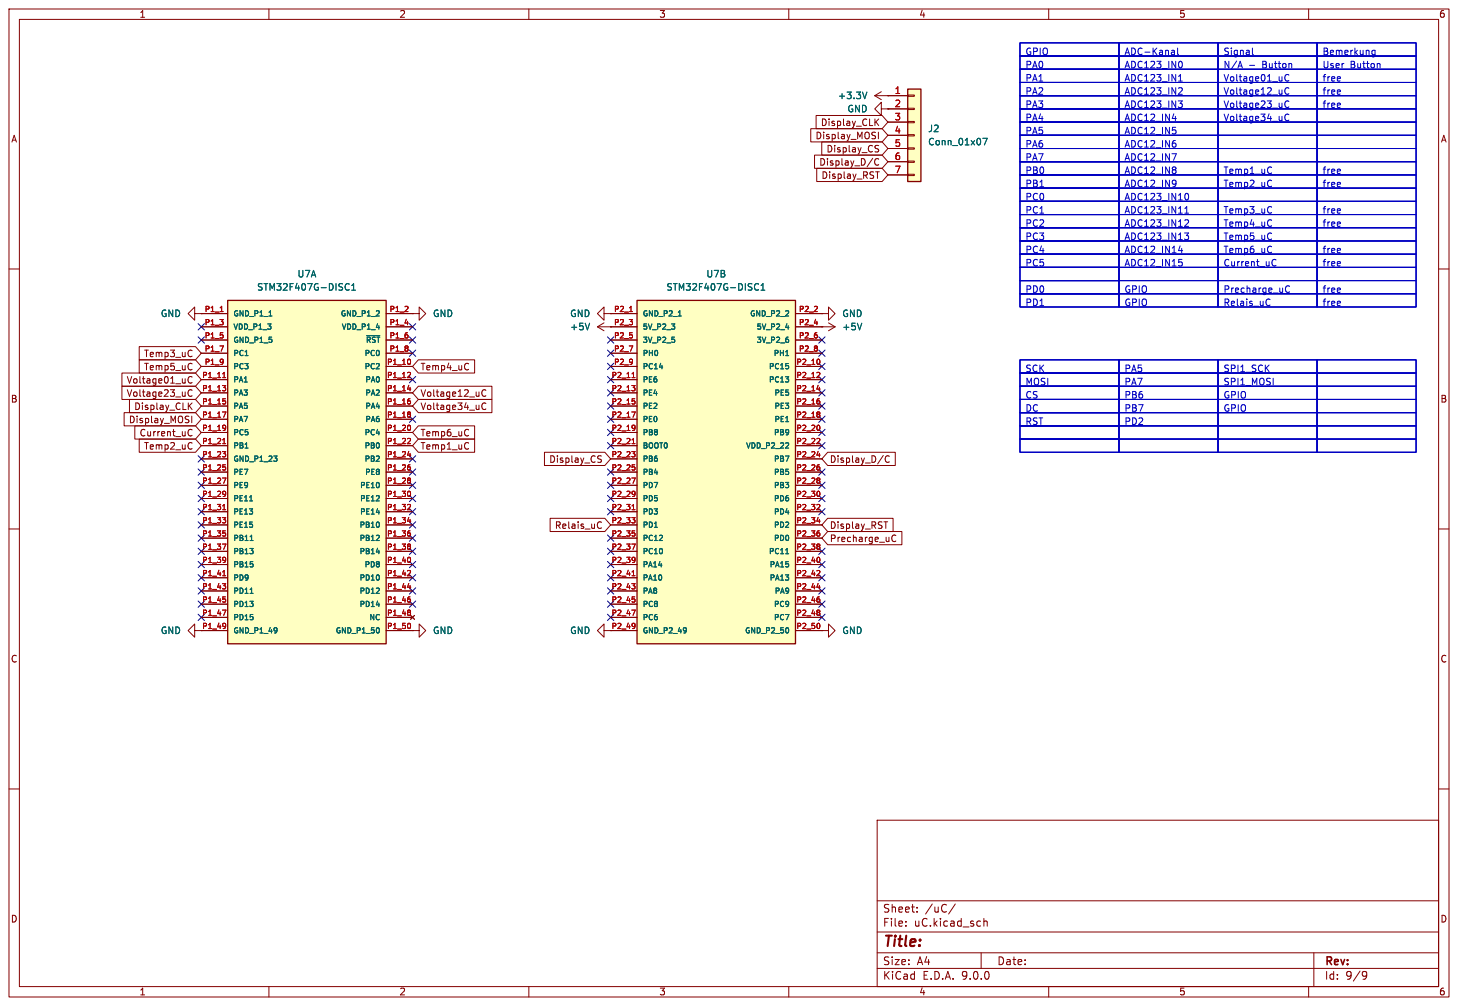
[picture p32: page 9]
