Viki-14/Projekt_BMS/BMS_PCB - V2/BMS_PCB.kicad_pcb

## KiCad design BMS_PCB - V2/BMS_PCB.kicad_pcb (2025-06-28)

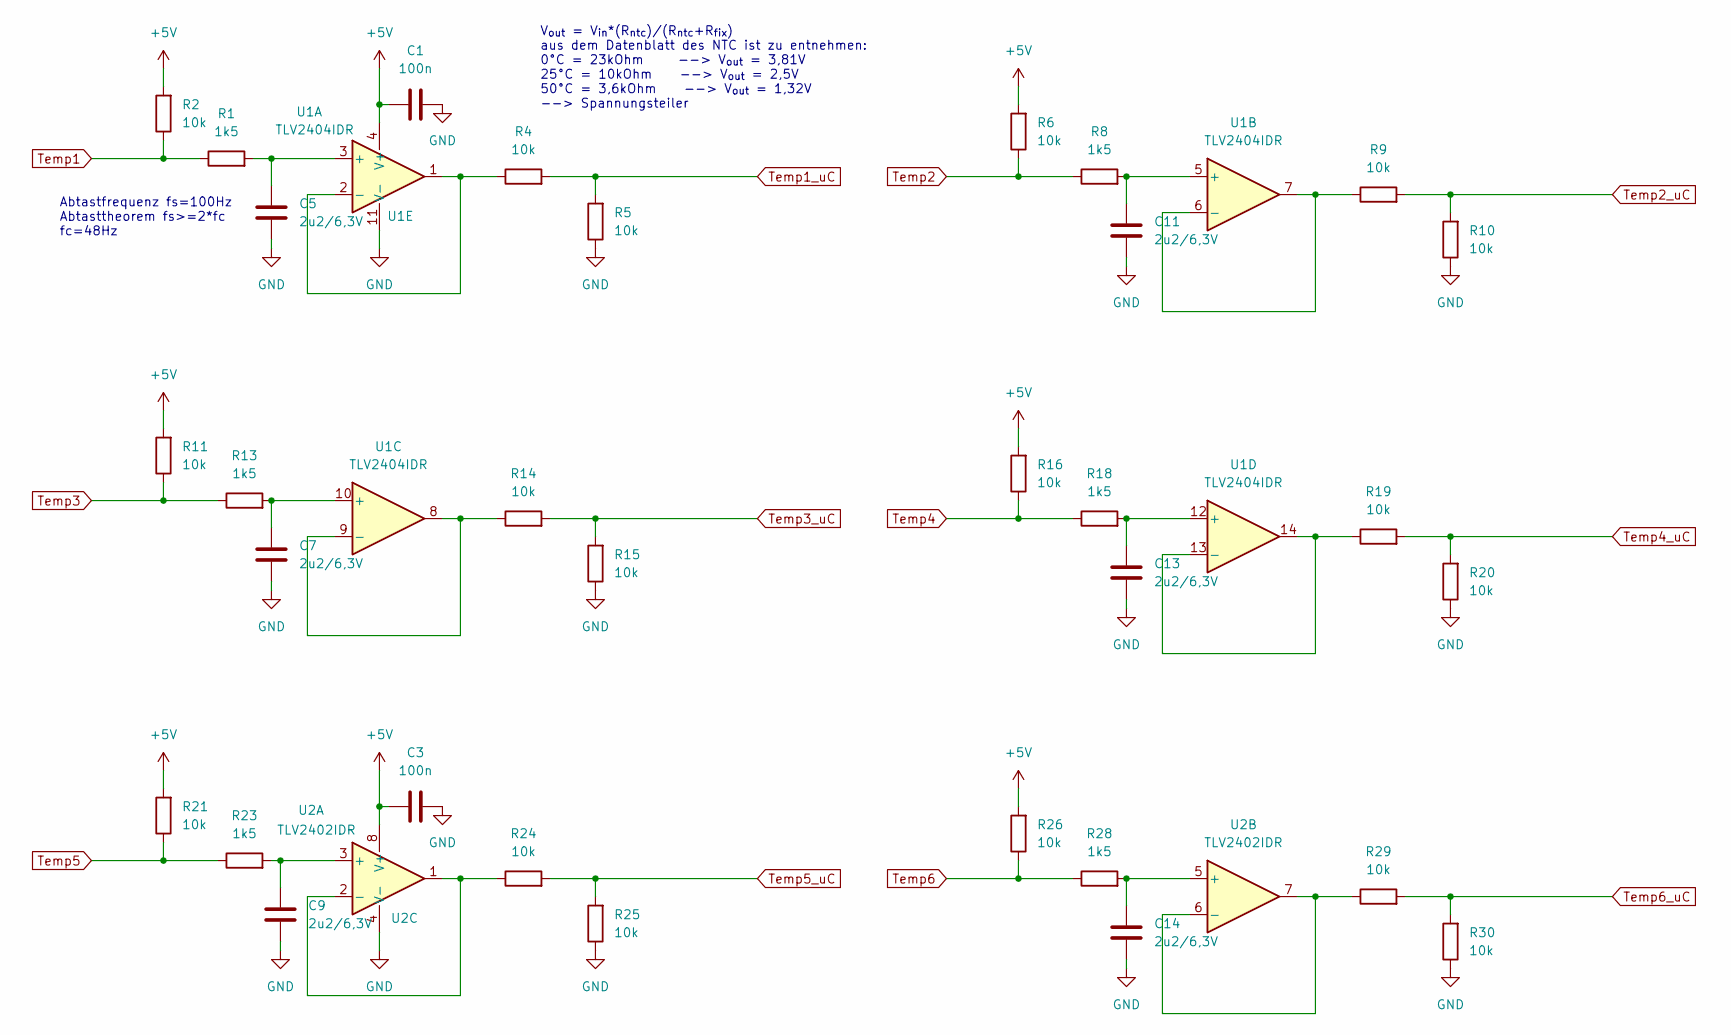
[picture p33: schematic Temperature Measurement.kicad_sch]

Parts:
C1, C3: 100n; C_0603_1608Metric_Pad1.08x0.95mm_HandSolder
C5, C7, C9, C11, C13, C14: 2u2/6,3V; C_0603_1608Metric_Pad1.08x0.95mm_HandSolder
R1, R8, R13, R18, R23, R28: 1k5; R_0603_1608Metric_Pad0.98x0.95mm_HandSolder
R2, R4, R5, R6, R9, R10, R11, R14, R15, R16, R19, R20, R21, R24, R25, R26, R29, R30: 10k; R_0603_1608Metric_Pad0.98x0.95mm_HandSolder
U1: TLV2404IDR; SOIC-14_3.9x8.7mm_P1.27mm
U2: TLV2402IDR; SOIC-8_3.9x4.9mm_P1.27mm

Connections:
+5V: C1.1, C3.1, R2.2, R6.2, R11.2, R16.2, R21.2, R26.2, U1.4 (V+), U2.8 (V+); also elsewhere on the board
GND: C1.2, C3.2, C5.2, C7.2, C9.2, C11.2, C13.2, C14.2, R5.1, R10.1, R15.1, R20.1, R25.1, R30.1, U1.11 (V-), U2.4 (V-); also elsewhere on the board
unnamed: C5.1, R1.2, U1.3 (+)
unnamed: R4.1, U1.1, U1.2 (-)
unnamed: C11.1, R8.2, U1.5 (+)
unnamed: R9.1, U1.6 (-), U1.7
unnamed: C7.1, R13.2, U1.10 (+)
unnamed: R14.1, U1.8, U1.9 (-)
unnamed: C13.1, R18.2, U1.12 (+)
unnamed: R19.1, U1.13 (-), U1.14
unnamed: C9.1, R23.2, U2.3 (+)
unnamed: R24.1, U2.1, U2.2 (-)
unnamed: C14.1, R28.2, U2.5 (+)
unnamed: R29.1, U2.6 (-), U2.7
Temp1: R1.1, R2.1; also elsewhere on the board
Temp1_uC: R4.2, R5.2; also elsewhere on the board
Temp2: R6.1, R8.1; also elsewhere on the board
Temp2_uC: R9.2, R10.2; also elsewhere on the board
Temp3: R11.1, R13.1; also elsewhere on the board
Temp3_uC: R14.2, R15.2; also elsewhere on the board
Temp4: R16.1, R18.1; also elsewhere on the board
Temp4_uC: R19.2, R20.2; also elsewhere on the board
Temp5: R21.1, R23.1; also elsewhere on the board
Temp5_uC: R24.2, R25.2; also elsewhere on the board
Temp6: R26.1, R28.1; also elsewhere on the board
Temp6_uC: R29.2, R30.2; also elsewhere on the board

Notes on the sheet:
V_{out} = V_{in}*(R_{ntc})/(R_{ntc}+R_{fix}) aus dem Datenblatt des NTC ist zu entnehmen: 0°C = 23kOhm --> V_{out} = 3,81V 25°C = 10kOhm --> V_{out} = 2,5V 50°C = 3,6kOhm --> V_{out} = 1,32V --> Spannungsteiler
Abtastfrequenz fs=100Hz Abtasttheorem fs>=2*fc fc=48Hz

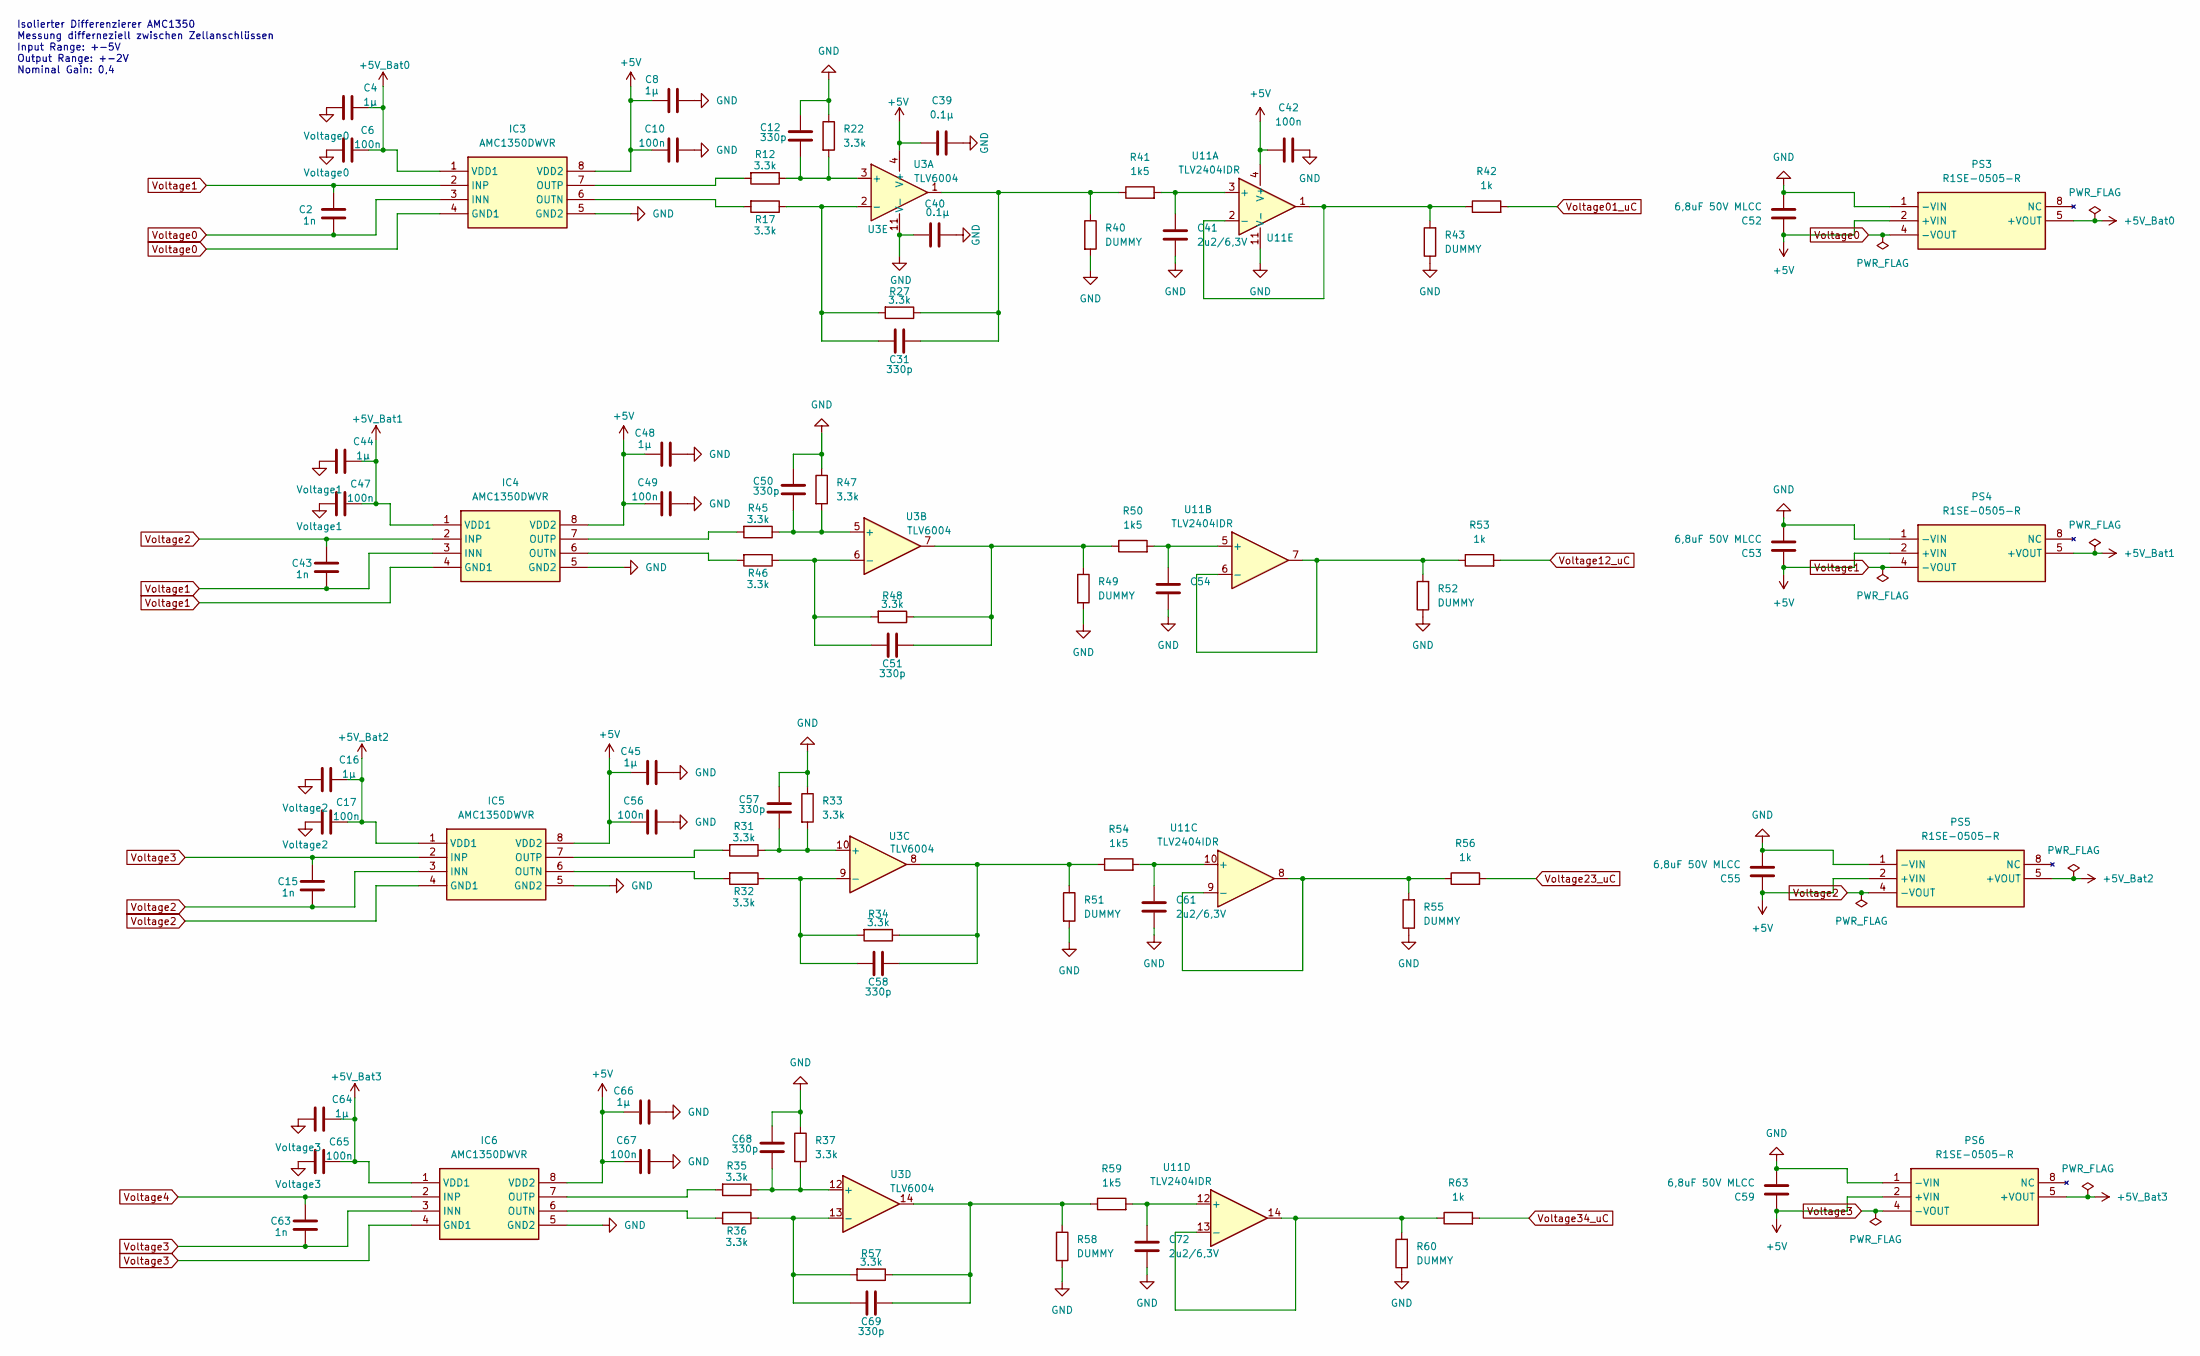
[picture p34: schematic Voltage Measurement.kicad_sch]

Parts:
C2, C15, C43, C63: 1n; C_0603_1608Metric_Pad1.08x0.95mm_HandSolder
C4, C8, C16, C44, C45, C48, C64, C66: 1µ; C_0603_1608Metric_Pad1.08x0.95mm_HandSolder
C6, C10, C17, C42, C47, C49, C56, C65, C67: 100n; C_0603_1608Metric_Pad1.08x0.95mm_HandSolder
C12, C31, C50, C51, C57, C58, C68, C69: 330p; C_0603_1608Metric_Pad1.08x0.95mm_HandSolder
C39, C40: 0.1µ; C_0603_1608Metric_Pad1.08x0.95mm_HandSolder
C41, C54, C61, C72: 2u2/6,3V; C_0603_1608Metric_Pad1.08x0.95mm_HandSolder
C52, C53, C55, C59: 6,8uF 50V MLCC; C_1206_3216Metric_Pad1.33x1.80mm_HandSolder
IC3, IC4, IC5, IC6: AMC1350DWVR; SOIC127P1150X280-8N; Mouser Part Number 595-AMC1350DWVR
PS3, PS4, PS5, PS6: R1SE-0505-R; R1SE0505; Mouser Part Number 919-R1SE-0505-R
R12, R17, R22, R27, R31, R32, R33, R34, R35, R36, R37, R45, R46, R47, R48, R57: 3.3k; R_0603_1608Metric_Pad0.98x0.95mm_HandSolder
R40, R43, R49, R51, R52, R55, R58, R60: DUMMY; R_0603_1608Metric_Pad0.98x0.95mm_HandSolder
R41, R50, R54, R59: 1k5; R_0603_1608Metric_Pad0.98x0.95mm_HandSolder
R42, R53, R56, R63: 1k; R_0603_1608Metric_Pad0.98x0.95mm_HandSolder
U3: TLV6004; TSSOP-14_4.4x5mm_P0.65mm
U11: TLV2404IDR; SOIC-14_3.9x8.7mm_P1.27mm

Connections:
+5V: C8.2, C10.1, C39.1, C42.1, C45.2, C48.2, C49.1, C52.1, C53.1, C55.1, C56.1, C59.1, C66.2, C67.1, IC3.8 (VDD2), IC4.8 (VDD2), IC5.8 (VDD2), IC6.8 (VDD2), PS3.2 (+VIN), PS4.2 (+VIN), PS5.2 (+VIN), PS6.2 (+VIN), U3.4 (V+), U11.4 (V+); also elsewhere on the board
+5V_Bat0: C4.1, C6.2, IC3.1 (VDD1), PS3.5 (+VOUT)
+5V_Bat1: C44.1, C47.2, IC4.1 (VDD1), PS4.5 (+VOUT)
+5V_Bat2: C16.1, C17.2, IC5.1 (VDD1), PS5.5 (+VOUT)
+5V_Bat3: C64.1, C65.2, IC6.1 (VDD1), PS6.5 (+VOUT)
GND: C8.1, C10.2, C12.1, C39.2, C40.1, C40.2, C41.2, C42.2, C45.1, C48.1, C49.2, C50.1, C52.2, C53.2, C54.2, C55.2, C56.2, C57.1, C59.2, C61.2, C66.1, C67.2, C68.1, C72.2, IC3.5 (GND2), IC4.5 (GND2), IC5.5 (GND2), IC6.5 (GND2), PS3.1 (-VIN), PS4.1 (-VIN), PS5.1 (-VIN), PS6.1 (-VIN), R22.1, R33.1, R37.1, R40.2, R43.1, R47.1, R49.2, R51.2, R52.1, R55.1, R58.2, R60.1, U3.11 (V-), U11.11 (V-); also elsewhere on the board
unnamed: C31.2, R27.1, R40.1, R41.1, U3.1
unnamed: C51.2, R48.1, R49.1, R50.1, U3.7
unnamed: C58.2, R34.1, R51.1, R54.1, U3.8
unnamed: C69.2, R57.1, R58.1, R59.1, U3.14
unnamed: IC3.6 (OUTN), R17.2
unnamed: IC3.7 (OUTP), R12.2
unnamed: IC4.6 (OUTN), R46.2
unnamed: IC4.7 (OUTP), R45.2
unnamed: IC5.6 (OUTN), R32.2
unnamed: IC5.7 (OUTP), R31.2
unnamed: IC6.6 (OUTN), R36.2
unnamed: IC6.7 (OUTP), R35.2
unnamed: C12.2, R12.1, R22.2, U3.3 (+)
unnamed: C31.1, R17.1, R27.2, U3.2 (-)
unnamed: C50.2, R45.1, R47.2, U3.5 (+)
unnamed: C51.1, R46.1, R48.2, U3.6 (-)
unnamed: C57.2, R31.1, R33.2, U3.10 (+)
unnamed: C58.1, R32.1, R34.2, U3.9 (-)
unnamed: C68.2, R35.1, R37.2, U3.12 (+)
unnamed: C69.1, R36.1, R57.2, U3.13 (-)
unnamed: C41.1, R41.2, U11.3 (+)
unnamed: R42.1, R43.2, U11.1, U11.2 (-)
unnamed: C54.1, R50.2, U11.5 (+)
unnamed: R52.2, R53.1, U11.6 (-), U11.7
unnamed: C61.1, R54.2, U11.10 (+)
unnamed: R55.2, R56.1, U11.8, U11.9 (-)
unnamed: C72.1, R59.2, U11.12 (+)
unnamed: R60.2, R63.1, U11.13 (-), U11.14
Voltage0: C2.2, C4.2, C6.1, IC3.3 (INN), IC3.4 (GND1), PS3.4 (-VOUT); also elsewhere on the board
Voltage1: C2.1, C43.2, C44.2, C47.1, IC3.2 (INP), IC4.3 (INN), IC4.4 (GND1), PS4.4 (-VOUT); also elsewhere on the board
Voltage01_uC: R42.2; also elsewhere on the board
Voltage2: C15.2, C16.2, C17.1, C43.1, IC4.2 (INP), IC5.3 (INN), IC5.4 (GND1), PS5.4 (-VOUT); also elsewhere on the board
Voltage3: C15.1, C63.2, C64.2, C65.1, IC5.2 (INP), IC6.3 (INN), IC6.4 (GND1), PS6.4 (-VOUT); also elsewhere on the board
Voltage4: C63.1, IC6.2 (INP); also elsewhere on the board
Voltage12_uC: R53.2; also elsewhere on the board
Voltage23_uC: R56.2; also elsewhere on the board
Voltage34_uC: R63.2; also elsewhere on the board

Notes on the sheet:
Isolierter Differenzierer AMC1350 Messung differneziell zwischen Zellanschlüssen Input Range: +-5V Output Range: +-2V Nominal Gain: 0,4

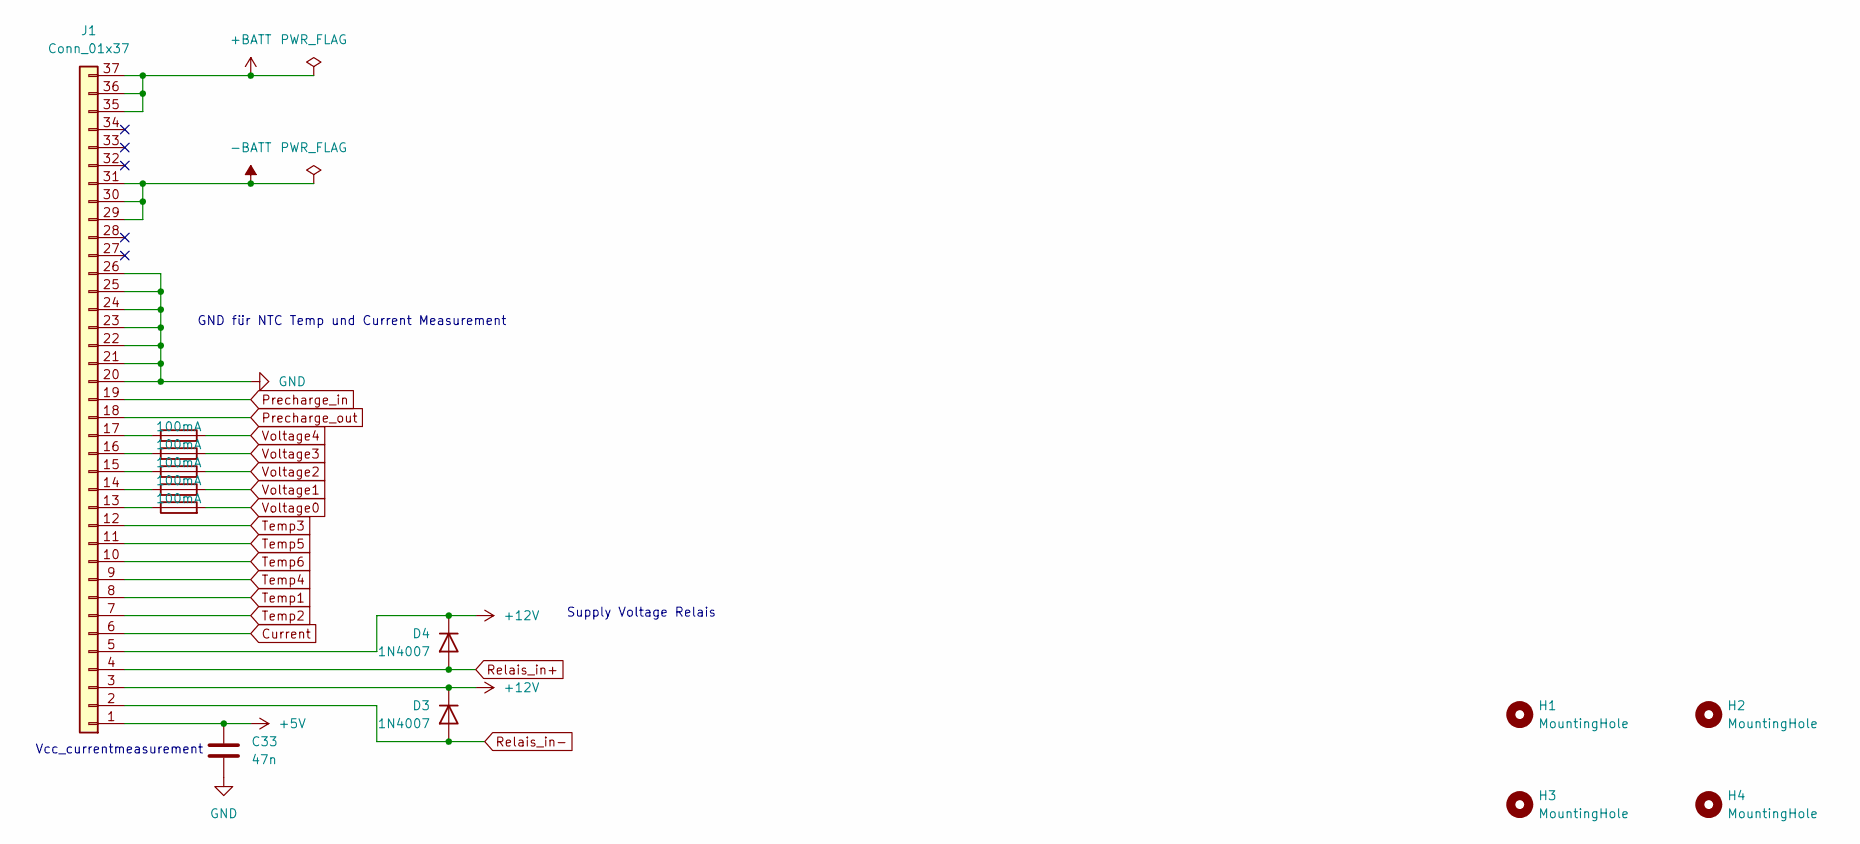
[picture p35: schematic Connectors.kicad_sch]

Parts:
C33: 47n; C_0603_1608Metric_Pad1.08x0.95mm_HandSolder
D3, D4: 1N4007; D_SMA
F1, F2, F3, F4, F6: 100mA; Fuse_Littelfuse-NANO2-451_453
H1, H2, H3, H4: MountingHole; MountingHole_3.5mm
J1: Conn_01x37; DSUB-37_Socket_Horizontal_P2.77x2.84mm_EdgePinOffset14.56mm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

Connections:
+12V: D3.1 (K), D4.1 (K), J1.3, J1.5; also elsewhere on the board
+BATT: J1.35, J1.36, J1.37; also elsewhere on the board
-BATT: J1.29, J1.30, J1.31; also elsewhere on the board
Current: J1.6; also elsewhere on the board
GND: C33.2, J1.20, J1.21, J1.22, J1.23, J1.24, J1.25, J1.26; also elsewhere on the board
unnamed: F6.1, J1.13
unnamed: F4.1, J1.14
unnamed: F3.1, J1.15
unnamed: F2.1, J1.16
unnamed: F1.1, J1.17
Precharge_in: J1.19; also elsewhere on the board
Precharge_out: J1.18; also elsewhere on the board
Relais_in+: D4.2 (A), J1.4; also elsewhere on the board
Relais_in-: D3.2 (A), J1.2; also elsewhere on the board
Temp1: J1.8; also elsewhere on the board
Temp2: J1.7; also elsewhere on the board
Temp3: J1.12; also elsewhere on the board
Temp4: J1.9; also elsewhere on the board
Temp5: J1.11; also elsewhere on the board
Temp6: J1.10; also elsewhere on the board
Voltage0: F6.2; also elsewhere on the board
Voltage1: F4.2; also elsewhere on the board
Voltage2: F3.2; also elsewhere on the board
Voltage3: F2.2; also elsewhere on the board
Voltage4: F1.2; also elsewhere on the board

Notes on the sheet:
Supply Voltage Relais
Vcc_currentmeasurement
GND für NTC Temp und Current Measurement

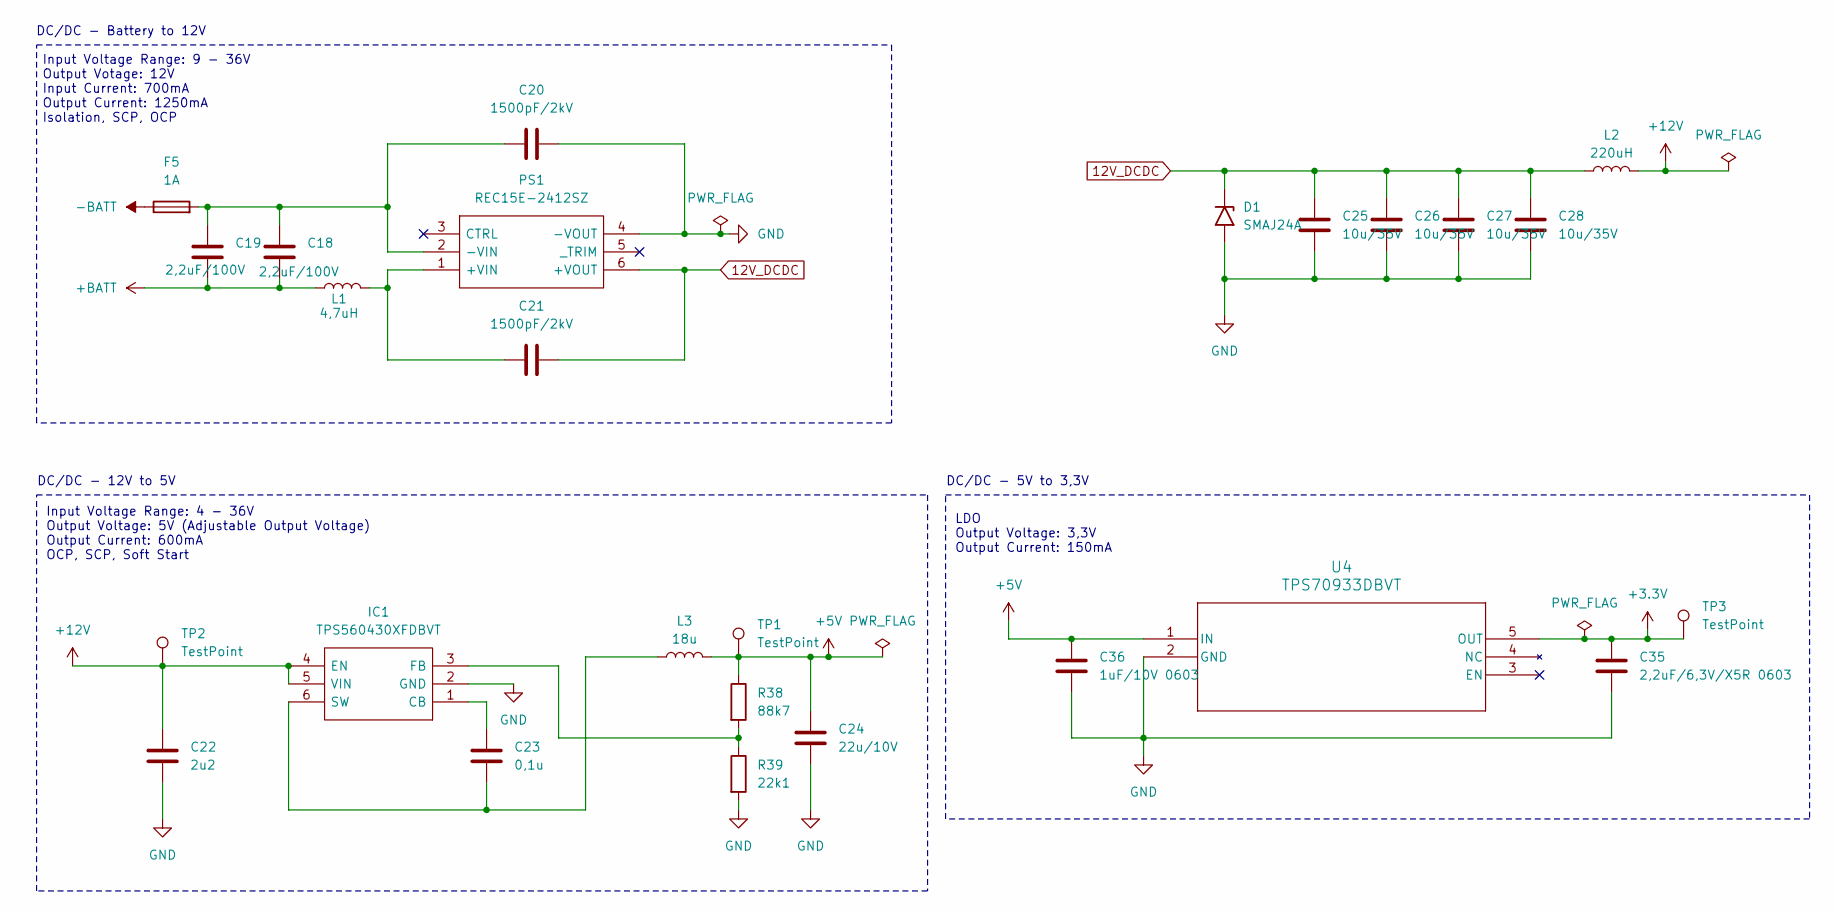
[picture p36: schematic DCDC.kicad_sch]

Parts:
C18, C19: 2,2uF/100V; C_0805_2012Metric_Pad1.18x1.45mm_HandSolder
C20, C21: 1500pF/2kV; C_1206_3216Metric_Pad1.33x1.80mm_HandSolder
C22: 2u2; C_0603_1608Metric_Pad1.08x0.95mm_HandSolder
C23: 0,1u; C_0603_1608Metric_Pad1.08x0.95mm_HandSolder
C24: 22u/10V; C_0603_1608Metric_Pad1.08x0.95mm_HandSolder
C25, C26, C27, C28: 10u/35V; C_0603_1608Metric_Pad1.08x0.95mm_HandSolder
C35: 2,2uF/6,3V/X5R 0603; C_0603_1608Metric_Pad1.08x0.95mm_HandSolder
C36: 1uF/10V 0603; C_0603_1608Metric_Pad1.08x0.95mm_HandSolder
D1: SMAJ24A; D_SMA
F5: 1A; Fuseholder_Littelfuse_Nano2_154x
IC1: TPS560430XFDBVT; SOT-23-6_Handsoldering; Mouser Part Number 595-TPS560430XFDBVT
L1: 4,7uH; L_Coilcraft_XxL4020
L2: 220uH; L_Wuerth_WE-PD2-Typ-L
L3: 18u; L_Bourns_SDR0604
PS1: REC15E-2412SZ; CONV_REC15E-2412SZ; Mouser Part Number 919-REC15E-2412SZ
R38: 88k7; R_0603_1608Metric_Pad0.98x0.95mm_HandSolder
R39: 22k1; R_0603_1608Metric_Pad0.98x0.95mm_HandSolder
TP1, TP2, TP3: TestPoint; TestPoint_Pad_D1.0mm
U4: TPS70933DBVT; SOT-23-5_HandSoldering

Connections:
12V_DCDC: C21.2, C25.1, C26.1, C27.1, C28.1, D1.1 (A1), L2.1, PS1.6 (+VOUT)
+5V: C24.1, C36.1, L3.2, R38.1, TP1.1, U4.1 (IN); also elsewhere on the board
+12V: C22.1, IC1.4 (EN), IC1.5 (VIN), L2.2, TP2.1; also elsewhere on the board
+BATT: C18.2, C19.2, L1.1; also elsewhere on the board
-BATT: F5.1; also elsewhere on the board
GND: C20.2, C22.2, C24.2, C25.2, C26.2, C27.2, C28.2, C35.2, C36.2, D1.2 (A2), IC1.2 (GND), PS1.4 (-VOUT), R39.2, U4.2 (GND); also elsewhere on the board
unnamed: C23.1, IC1.1 (CB)
unnamed: IC1.3 (FB), R38.2, R39.1
unnamed: C23.2, IC1.6 (SW), L3.1
unnamed: C21.1, L1.2, PS1.1 (+VIN)
unnamed: C18.1, C19.1, C20.1, F5.2, PS1.2 (-VIN)

Notes on the sheet:
Input Voltage Range: 4 - 36V Output Voltage: 5V (Adjustable Output Voltage) Output Current: 600mA OCP, SCP, Soft Start
DC/DC - Battery to 12V
DC/DC - 12V to 5V
LDO Output Voltage: 3,3V Output Current: 150mA
Input Voltage Range: 9 - 36V Output Votage: 12V Input Current: 700mA Output Current: 1250mA Isolation, SCP, OCP
DC/DC - 5V to 3,3V

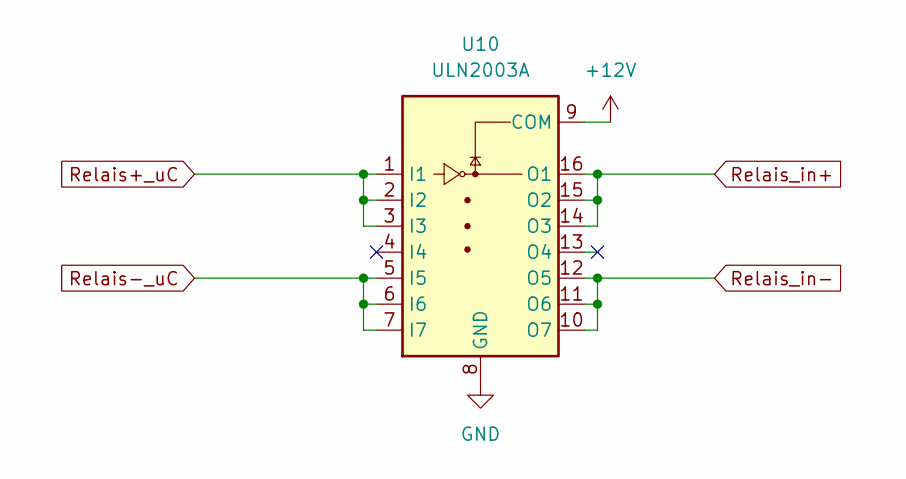
[picture p37: schematic Main Contactor Control.kicad_sch]

Parts:
U10: ULN2003A; SOIC-16_3.9x9.9mm_P1.27mm

Connections:
+12V: U10.9 (COM); also elsewhere on the board
GND: U10.8 (GND); also elsewhere on the board
Relais+_uC: U10.1 (I1), U10.2 (I2), U10.3 (I3); also elsewhere on the board
Relais-_uC: U10.5 (I5), U10.6 (I6), U10.7 (I7); also elsewhere on the board
Relais_in+: U10.14 (O3), U10.15 (O2), U10.16 (O1); also elsewhere on the board
Relais_in-: U10.10 (O7), U10.11 (O6), U10.12 (O5); also elsewhere on the board

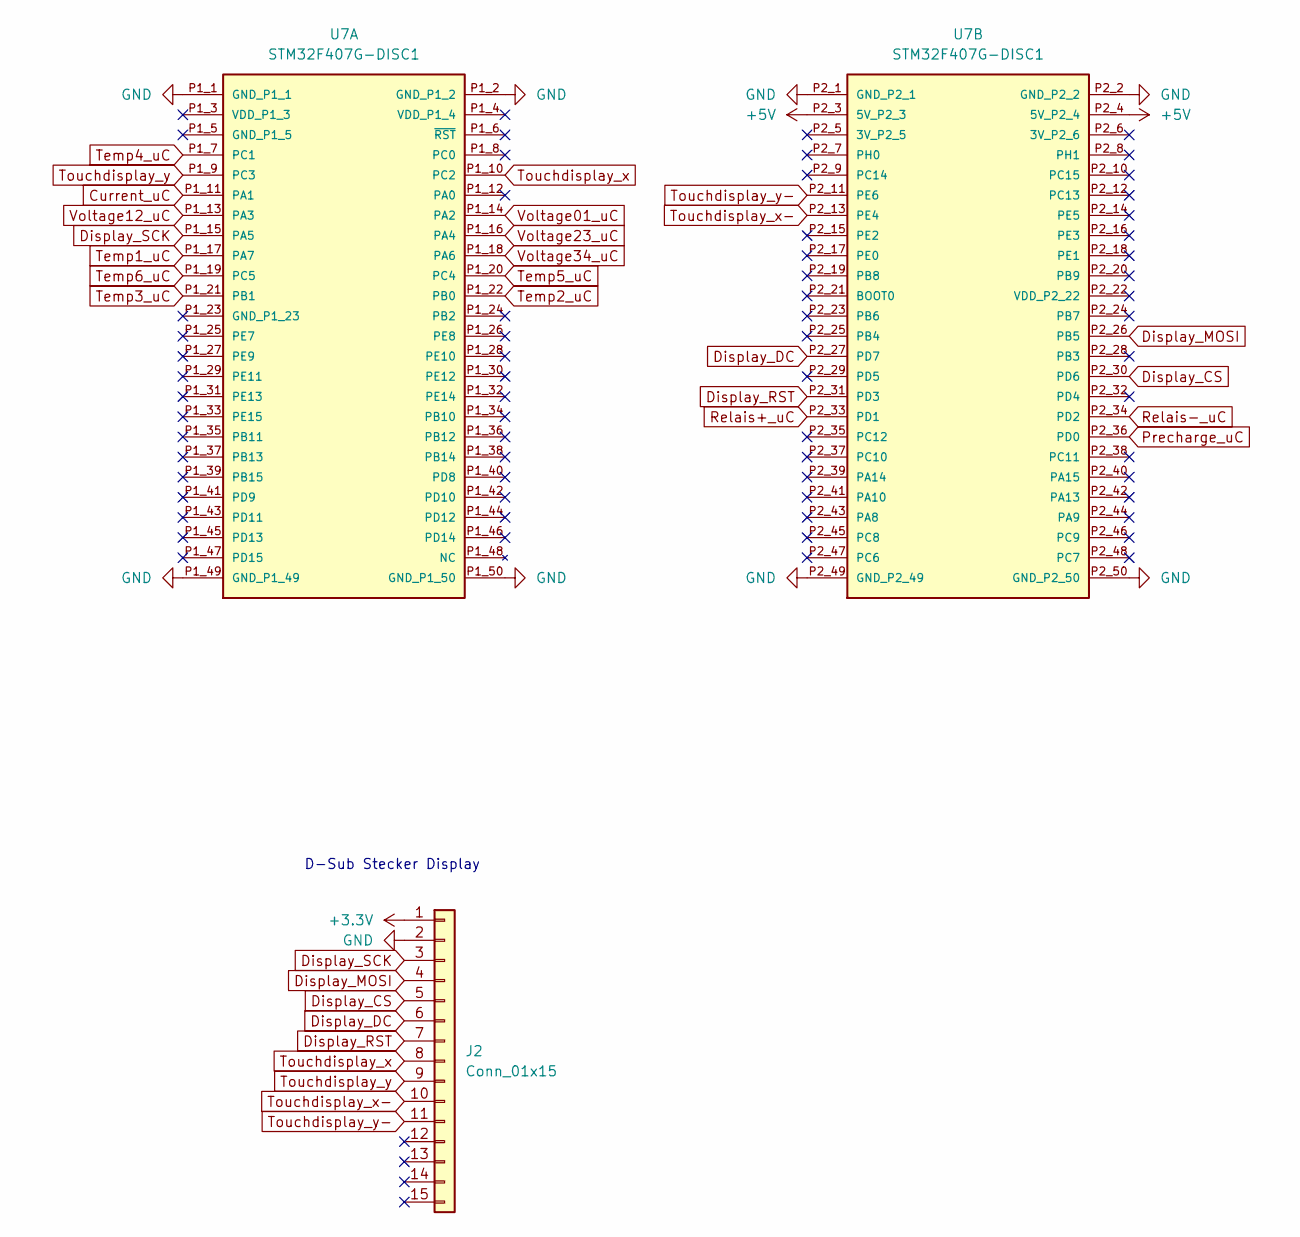
[picture p38: schematic uC.kicad_sch]

Parts:
J2: Conn_01x15; DSUB-15_Socket_Horizontal_P2.77x2.84mm_EdgePinOffset14.56mm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
U7: STM32F407G-DISC1; MODULE_STM32F407G-DISC1; PARTREV 7

Connections:
+5V: U7.P2_3 (5V_P2_3), U7.P2_4 (5V_P2_4); also elsewhere on the board
Current_uC: U7.P1_11 (PA1); also elsewhere on the board
Display_CS: J2.5, U7.P2_30 (PD6)
Display_DC: J2.6, U7.P2_27 (PD7)
Display_MOSI: J2.4, U7.P2_26 (PB5)
Display_RST: J2.7, U7.P2_31 (PD3)
Display_SCK: J2.3, U7.P1_15 (PA5)
GND: J2.2, U7.P1_1 (GND_P1_1), U7.P1_2 (GND_P1_2), U7.P1_49 (GND_P1_49), U7.P1_50 (GND_P1_50), U7.P2_1 (GND_P2_1), U7.P2_2 (GND_P2_2), U7.P2_49 (GND_P2_49), U7.P2_50 (GND_P2_50); also elsewhere on the board
Precharge_uC: U7.P2_36 (PD0); also elsewhere on the board
Relais+_uC: U7.P2_33 (PD1); also elsewhere on the board
Relais-_uC: U7.P2_34 (PD2); also elsewhere on the board
Temp1_uC: U7.P1_17 (PA7); also elsewhere on the board
Temp2_uC: U7.P1_22 (PB0); also elsewhere on the board
Temp3_uC: U7.P1_21 (PB1); also elsewhere on the board
Temp4_uC: U7.P1_7 (PC1); also elsewhere on the board
Temp5_uC: U7.P1_20 (PC4); also elsewhere on the board
Temp6_uC: U7.P1_19 (PC5); also elsewhere on the board
Touchdisplay_x: J2.8, U7.P1_10 (PC2)
Touchdisplay_x-: J2.10, U7.P2_13 (PE4)
Touchdisplay_y: J2.9, U7.P1_9 (PC3)
Touchdisplay_y-: J2.11, U7.P2_11 (PE6)
Voltage01_uC: U7.P1_14 (PA2); also elsewhere on the board
Voltage12_uC: U7.P1_13 (PA3); also elsewhere on the board
Voltage23_uC: U7.P1_16 (PA4); also elsewhere on the board
Voltage34_uC: U7.P1_18 (PA6); also elsewhere on the board

Notes on the sheet:
D-Sub Stecker Display

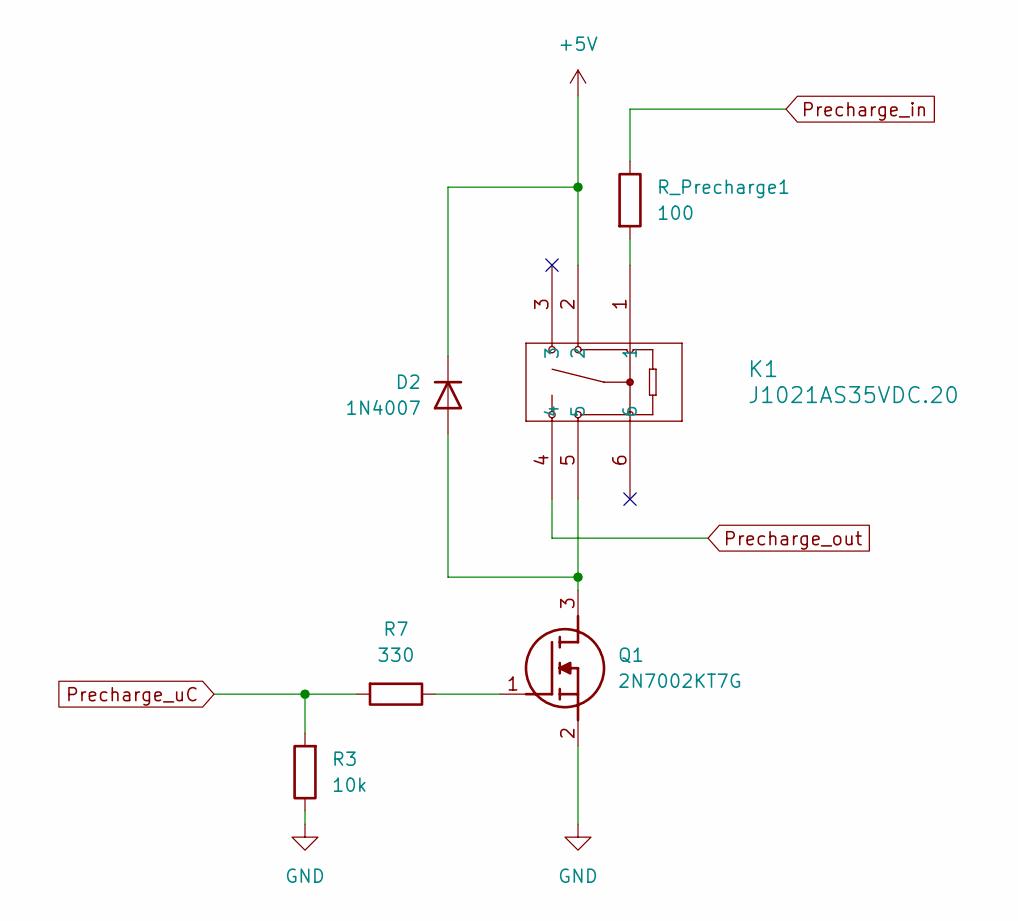
[picture p39: schematic Precharge.kicad_sch]

Parts:
D2: 1N4007; D_SMA
K1: J1021AS35VDC.20; J1021AS_CRS
Q1: 2N7002KT7G; SOT-23-3; Mouser Part Number 863-2N7002KT7G
R3: 10k; R_0603_1608Metric_Pad0.98x0.95mm_HandSolder
R7: 330; R_0603_1608Metric_Pad0.98x0.95mm_HandSolder
R_Precharge1: 100; R_2816_7142Metric_Pad3.20x4.45mm_HandSolder

Connections:
+5V: D2.1 (K), K1.2; also elsewhere on the board
GND: Q1.2 (S), R3.1; also elsewhere on the board
unnamed: D2.2 (A), K1.5, Q1.3 (D)
unnamed: Q1.1 (G), R7.1
Precharge_in: R_Precharge1.1; also elsewhere on the board
Precharge_out: K1.4; also elsewhere on the board
Precharge_uC: R3.2, R7.2; also elsewhere on the board

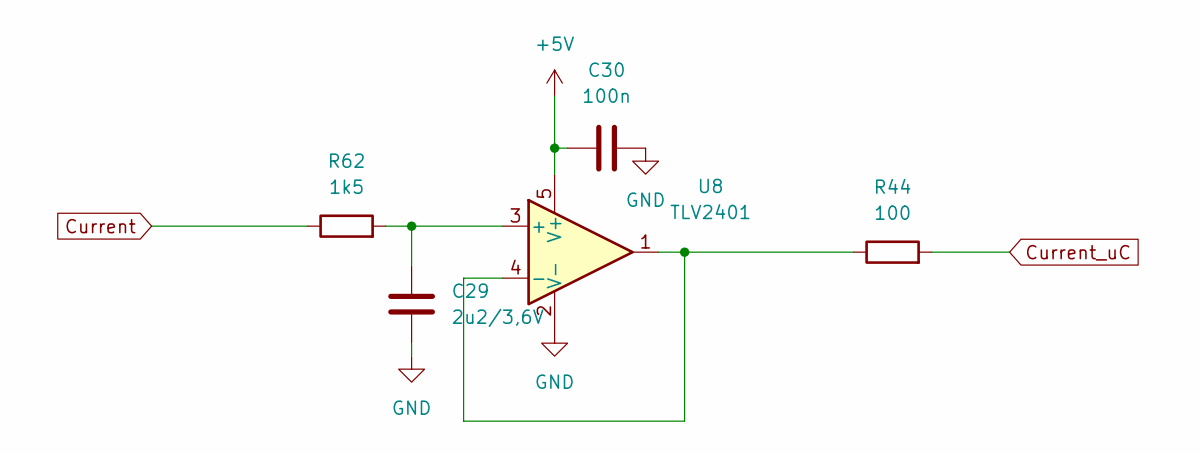
[picture p40: schematic Current Measurement.kicad_sch]

Parts:
C29: 2u2/3,6V; C_0603_1608Metric_Pad1.08x0.95mm_HandSolder
C30: 100n; C_0603_1608Metric_Pad1.08x0.95mm_HandSolder
R44: 100; R_0603_1608Metric_Pad0.98x0.95mm_HandSolder
R62: 1k5; R_0603_1608Metric_Pad0.98x0.95mm_HandSolder
U8: TLV2401; SOT-23-5_HandSoldering

Connections:
+5V: C30.1, U8.5 (V+); also elsewhere on the board
Current: R62.1; also elsewhere on the board
Current_uC: R44.2; also elsewhere on the board
GND: C29.2, C30.2, U8.2 (V-); also elsewhere on the board
unnamed: C29.1, R62.2, U8.3 (+)

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
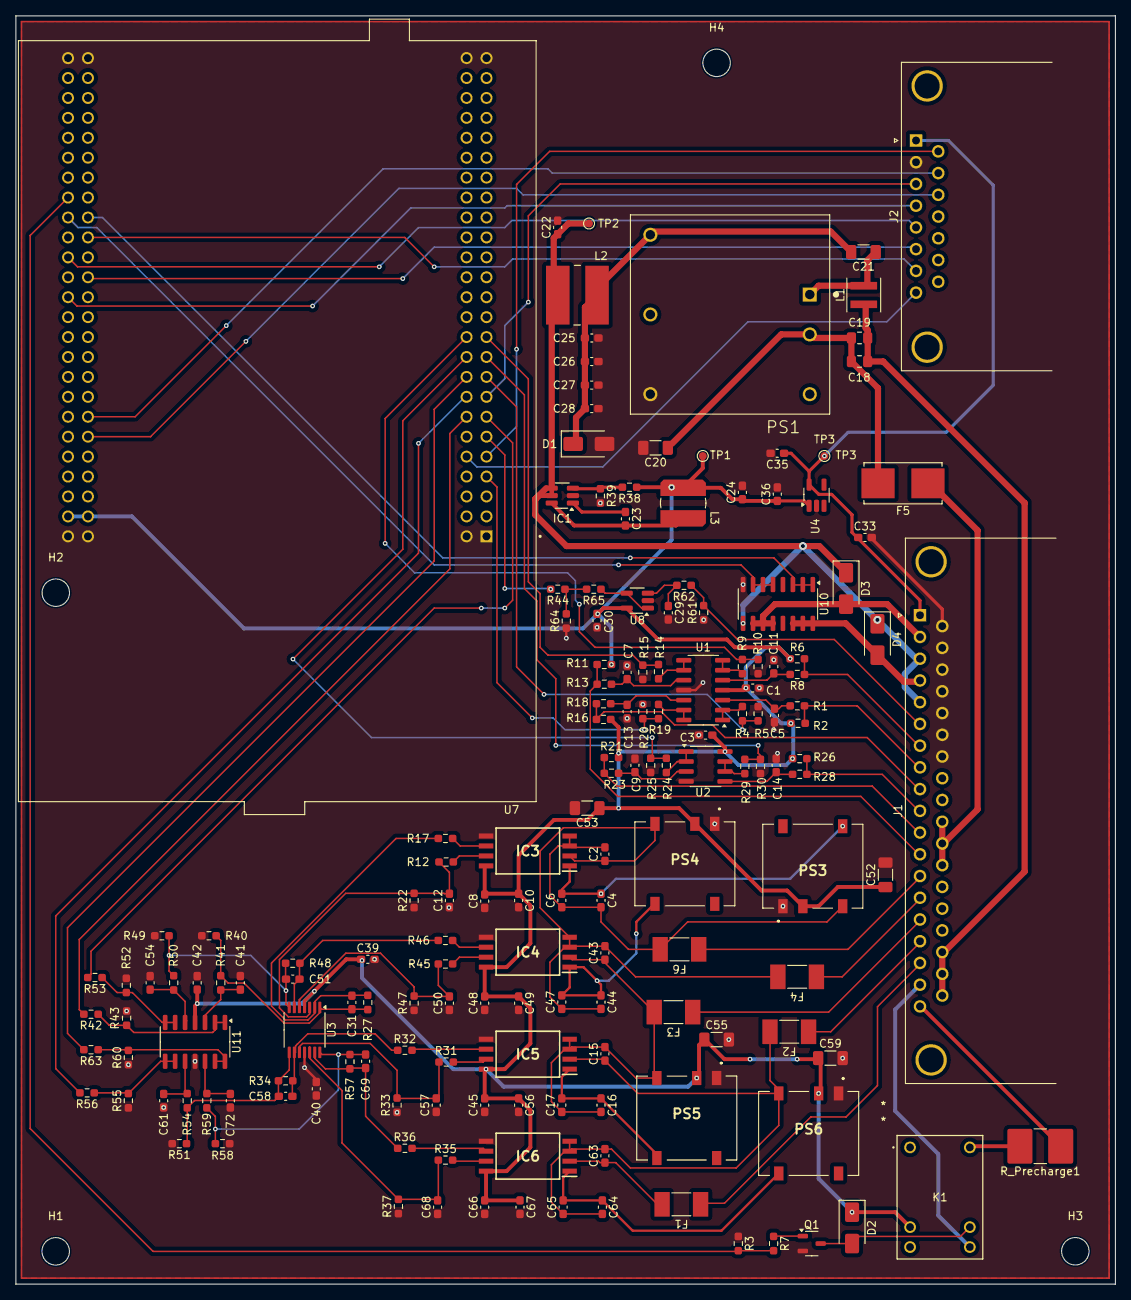
[picture p41: board BMS_PCB.kicad_pcb from above]

Board: 2 copper layers, 140.2 x 161.7 mm, 171 parts (0 on the bottom side), 106 nets.

Other parts of the board:
R61, R64, R65: DUMMY; R_0603_1608Metric_Pad0.98x0.95mm_HandSolder

Their connections:
Current: R61.2; also elsewhere on the board
GND: R61.1, R64.1; also elsewhere on the board
