Viki-14/Projekt_BMS/BMS_Software/Alte Versionen/Core/Src/main.c

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
/* Includes ------------------------------------------------------------------*/
#include "main.h"
#include "usb_host.h"

/* USER CODE BEGIN Includes */

#include <stdbool.h>
#include "functions.h"

/* USER CODE END Includes */

/* USER CODE BEGIN PTD */

typedef enum {
    STATE_INIT,
    STATE_FAULT,
    STATE_IDLE,
    STATE_PRECHARGE,
    STATE_ACTIVE
} SystemState;

/* USER CODE END PTD */

ADC_HandleTypeDef hadc1;
ADC_HandleTypeDef hadc2;
ADC_HandleTypeDef hadc3;
DMA_HandleTypeDef hdma_adc1;
DMA_HandleTypeDef hdma_adc2;
DMA_HandleTypeDef hdma_adc3;

SPI_HandleTypeDef hspi1;

/* USER CODE BEGIN PV */

//UserButton
uint8_t button_pressed = 0;
uint8_t last_button_state = 0;
bool button_state = false;

//Measurements
float VoltageMeasurement1 = 0;
float VoltageMeasurement2 = 0;
float VoltageMeasurement3 = 0;
float VoltageMeasurement4 = 0;
float VoltageMeasurementTotal = 0;
float TempMeasurement1 = 0;
float TempMeasurement2 = 0;
float TempMeasurement3 = 0;
float TempMeasurement4 = 0;
float TempMeasurement5 = 0;
float TempMeasurement6 = 0;
float CurrentMeasurement = 0;

//Threshold-Values
float ThresholdVoltageLow = 2.55f;
float ThresholdVoltageHigh = 4.15f;
float ThresholdTempLow = 0.0f;
float ThresholdTempHigh = 50.0f;
float ThresholdCurrentLow = -9.0f;
float ThresholdCurrentHigh = 90.0f;

//RunTime
int RunTime; //(lokal: int hour=0; int mins=0; int secs=0;)

//Button Display
bool ButtonContactor = false; //(false (=open) or true (=closed) initial?)

/* USER CODE END PV */

void SystemClock_Config(void);
static void MX_GPIO_Init(void);
static void MX_DMA_Init(void);
static void MX_ADC1_Init(void);
static void MX_ADC2_Init(void);
static void MX_ADC3_Init(void);
static void MX_SPI1_Init(void);
void MX_USB_HOST_Process(void);

/**
  * @brief  The application entry point.
  * @retval int
  */
int main(void)
{

  /* MCU Configuration--------------------------------------------------------*/

  /* Reset of all peripherals, Initializes the Flash interface and the Systick. */
  HAL_Init();

  /* Configure the system clock */
  SystemClock_Config();

  /* Initialize all configured peripherals */
  MX_GPIO_Init();
  MX_DMA_Init();
  MX_USB_HOST_Init();
  MX_ADC1_Init();
  MX_ADC2_Init();
  MX_ADC3_Init();
  MX_SPI1_Init();
  /* USER CODE BEGIN 2 */

  /*-------------------------------------------------------------------------------------------------------------------------------------------------------
   * MAIN-LOGIC
   * ------------------------------------------------------------------------------------------------------------------------------------------------------*/

  while (1)
      {
          // Aktuellen Zustand des Buttons lesen
          button_pressed = HAL_GPIO_ReadPin(GPIOA, GPIO_PIN_0);

          // Rising Edge Erkennung: nur reagieren, wenn der Button von "nicht gedrückt" auf "gedrückt" wechselt
          if (button_pressed && !last_button_state)
          {
              button_state = !button_state; // Zustand umschalten

              Relais_control();			//Precharge_Relais Funktion
          }

          // Vorherigen Button-Zustand speichern
          last_button_state = button_pressed;

          HAL_Delay(20); // kleine Entprellung
      }
  /* USER CODE END 2 */

  /* Infinite loop */
  /* USER CODE BEGIN WHILE */
  while (1)
  {
    /* USER CODE END WHILE */
    MX_USB_HOST_Process();

    /* USER CODE BEGIN 3 */
  }
  /* USER CODE END 3 */
}

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
