Viki-14/Projekt_BMS/BMS_Software/Alte Versionen/Core/Inc/functions.h

/*
 * functions.h
 *
 *  Created on: May, 2025
 *      Author: AlexP
 */

#include "main.h"
#include <stdbool.h>

#ifndef INC_FUNCTIONS_H_
#define INC_FUNCTIONS_H_

void Relais_control(void);
void Voltage_Measurement(void);
void Temp_Measurement(void);
void Current_Measurement(void);
void Display_Configuration(void);

#endif /* INC_FUNCTIONS_H_ */
