Viki-14/Projekt_BMS/(commit log)

2025-04-24 Test
    Test
    [BMS_PCB.kicad_pcb]
2025-04-24 Update uC.kicad_sch
    changed gpio pins
    [uC.kicad_sch]
2025-04-25 Freitag
    Ich habe heute viele Bauteile zusammengesetzt. Die Leiterbahnen würde ich eher zum Schluss machen.
    [BMS_PCB.kicad_pcb]
2025-04-27 Sonntag
    Ich habe das Layout weitergemacht, die restlichen Schaltungen zusammengestellt und das meiste bereits verbunden. Problem sind noch die PS-Boxen (R1SE-0505-R), die für die Voltage Messung noch angeschlossen werden müssen. da müssen wir schauen, wie wir die platztechnisch platzieren.
    [BMS_PCB.kicad_pcb]
2025-04-28 Montag, 28.04.
    Pin Belegung PCB geändert, noch nicht in Schematics
    PS-Boxen platziert
    80 % fertig verteilt und verbunden
    [BMS_PCB.kicad_pcb]
2025-04-28 Changes Schematic
    - Symbol Relais
    - add DUMMY
    - changed Fuses 100mA
    [Connectors.kicad_sch, Current Measurement.kicad_sch, Precharge.kicad_sch, uC.kicad_sch]
2025-04-29 Footprints changes
    -U10
    -uC pins/SPI changes
    - Fuses
    - DSUB
    - reupload layout
    - etc.
    [BMS_PCB.kicad_pcb, Current Measurement.kicad_sch, DCDC.kicad_sch, Main Contactor Control.kicad_sch, uC.kicad_sch]
2025-04-29 Connector
    Ich hab die Pinbelegung vom DSUB Stecker in Schematics geändert
    [Connectors.kicad_sch, uC.kicad_sch]
2025-04-29 Dienstag, 29.04.
    Layout soweit fertig gestellt, Probleme noch mit Footprints
    [BMS_PCB.kicad_pcb]
2025-04-30 kleine Änderungen
    Grounding angepasst
    Connector angepasst
    Beschriftung angepasst
    [BMS_PCB.kicad_pcb, Connectors.kicad_sch, uC.kicad_sch]
2025-04-30 Bugfixes
    noch ein paar Fehler ausgemerzt
    [BMS_PCB.kicad_pcb, Connectors.kicad_sch, Precharge.kicad_sch, uC.kicad_sch]
2025-04-30 Mittwoch 30.04.
    Quadratisch Praktisch Gut
    [BMS_PCB.kicad_pcb]
2025-05-02 Bohrungen platziert
    [BMS_PCB.kicad_pcb]
2025-05-02 Relais_in+ Leiterbahn vergrößert
    [BMS_PCB.kicad_pcb]
2025-05-02 Bugfix Leiterbahn
    [BMS_PCB.kicad_pcb]
2025-05-02 Edge Cut hinzugefügt
    [BMS_PCB.kicad_pcb, BMS_PCB.step]
2025-05-03 changes schematic
    still missing: uC pins
    [Connectors.kicad_sch, Current Measurement.kicad_sch, Main Contactor Control.kicad_sch, Voltage Measurement.kicad_sch, uC.kicad_sch]
2025-05-04 schematic uC
    changes schematic uC
    [Connectors.kicad_sch, uC.kicad_sch]
2025-05-04 few changes
    [BMS_PCB.kicad_pcb, uC.kicad_sch]
2025-05-04 Sonntag, 04.05.
    Leiterbahndicken angepasst, Bohrlöcher erneuert, µC final angeschlossen, letzte Bugfixes
    [BMS_PCB.kicad_pcb, BMS_PCB.step, Connectors.kicad_sch, DCDC.kicad_sch, uC.kicad_sch]
2025-05-04 MountingHoles hinzugefügt
    MountingHoles sind jetzt auch in den Schematics
    [BMS_PCB.kicad_pcb]
2025-05-04 Update
    Leiterbahndicke +5V von 0,4 auf 0,5 mm geändert
    [BMS_PCB.kicad_pcb]
2025-05-04 Update 2
    eine Leiterbahn GND von 0,2 auf 0,3 mm verbreitert
    [BMS_PCB.kicad_pcb]
2025-05-04 Bohrlöcher
    Löcher auf 3,5 mm geändert
    [BMS_PCB.kicad_pcb, Connectors.kicad_sch, uC.kicad_sch]
2025-05-04 Bohrlöcher geändert
    [BMS_PCB.step]
2025-05-04 12V auf 0,8 mm
    [BMS_PCB.kicad_pcb]
2025-05-05 GND verbunden
    [BMS_PCB.kicad_pcb]
2025-05-05 Bugfix
    Capacity und Resistors
    [Connectors.kicad_sch, DCDC.kicad_sch, Voltage Measurement.kicad_sch, uC.kicad_sch]
2025-05-05 Update
    Bohrlöcher
    [BMS_PCB.kicad_pcb]
2025-05-05 Update Step
    [BMS_PCB.step]
2025-05-05 Gerber Files
    [BMS_PCB-B_Cu.gbr, BMS_PCB-B_Mask.gbr, BMS_PCB-B_Silkscreen.gbr, BMS_PCB-Edge_Cuts.gbr, BMS_PCB-F_Cu.gbr, BMS_PCB-F_Mask.gbr, BMS_PCB-F_Silkscreen.gbr, BMS_PCB-NPTH.drl]
2025-05-12 V1
    Erste Übergabe der Softwaredateien
2025-05-12 Mit Buttonvariable für Display
2025-05-17 BMS_Software_Project
    Softwareproject (Stand 12.05.25)
2025-05-18 Create Batterymanagementsystem_current.zip
    Erweiterung zu C++ Projekt
    Hinzufügen von Display files (noch fehlerhaft --> cmsis_os.h file nicht definiert (RTOS Notwendigkeit?))
2025-05-20 Display Erweiterung
    Erweiterung der Files und Start der Fehlerbehebung der Files
2025-05-27 Initialisierung Display files
    Hinzufügen (hoffentlich aller) benötigter Files, die für das Display notwendig sind
2025-06-02 Umbenennung Ordner (Reihenfolge)
    Umbenennung, sodass die Versionen chronologisch angeordnet bleiben
2025-06-03 Hinzufügen globaler Variable buttonContactor für Relais/Schütz-Ansteuerung
2025-06-03 Zusammenführung der Software
2025-06-13 Create Batteriemanagementsystem_13_06_ohne_Buffer_Display.zip
    nur ADC-Messung und state machine ohne Display + Buffer
2025-06-17 Neuaufsetzung Projekt und Fehlersuche
2025-06-17 Hinzufügen der Clock-Config
2025-06-28 schematic überarbeitet
    [AMC1350DWVR.stp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]
