Viki-14/Projekt_BMS/(notices)

Notices in the files:
BMS_Software/Alte Versionen/Core/Inc/main.h:
Copyright (c) 2025 STMicroelectronics.
All rights reserved.
This software is licensed under terms that can be found in the LICENSE file
